IoT-App-Development-Company/AdequateSolarCold/cold-room-design/ColdRoom/3D Renders/AdequateSolarCold_Render_02.png

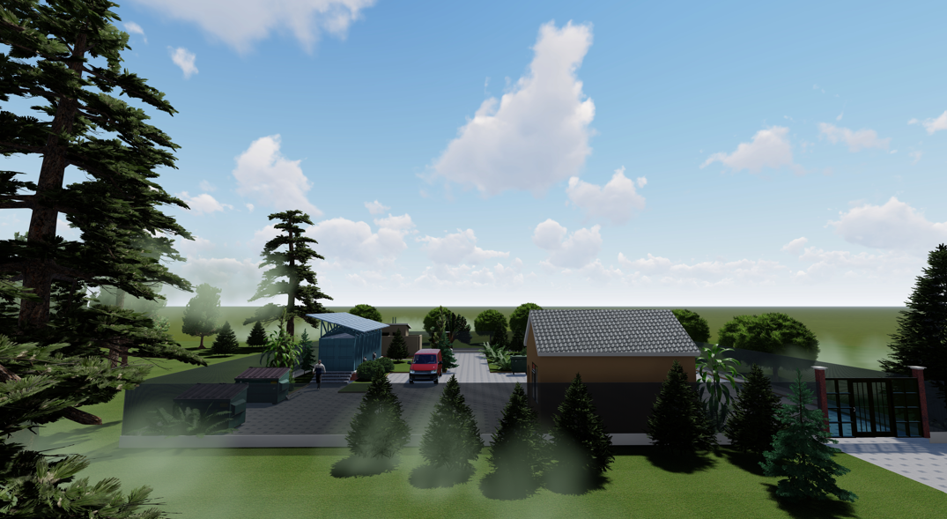
cold-room-design/ColdRoom/3D Renders/AdequateSolarCold_Render_02.png
