IoT-App-Development-Company/AdequateSolarCold/cold-room-design/ColdRoom/CAD Exports/AdequateSolarCold_Exterior.PNG

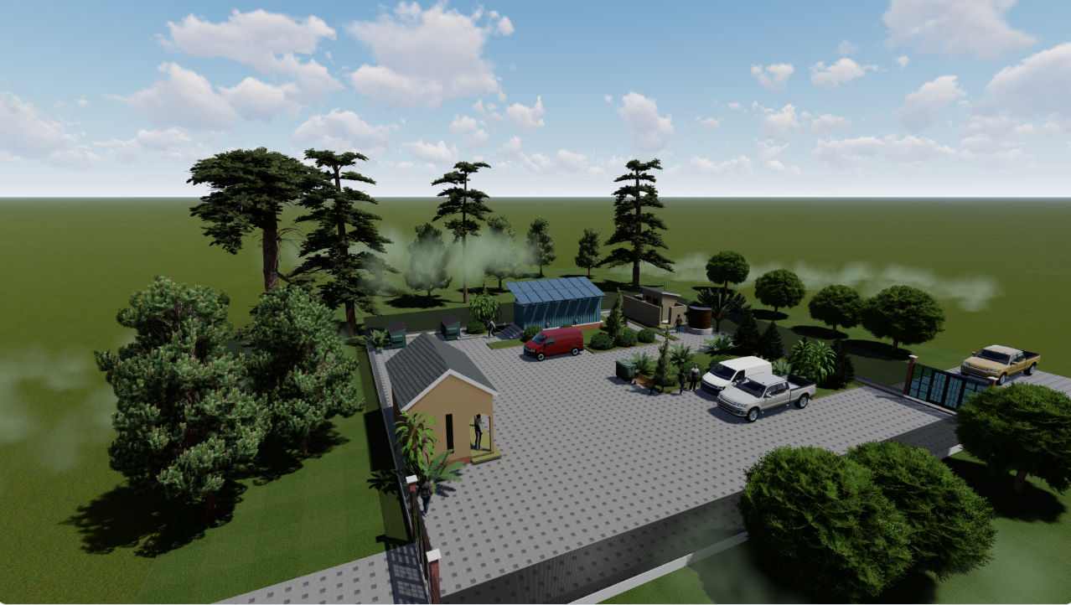
cold-room-design/ColdRoom/CAD Exports/AdequateSolarCold_Exterior.PNG
