IoT-App-Development-Company/AdequateSolarCold/docs/README.md

# Adequate SolarCold documentation

This VitePress site documents the Adequate Infosoft solar cold-chain platform.

## Local development

```text
npm install
npm run docs:dev
```

Use `npm run docs:build` before publishing. The site does not include production analytics or repository-host-specific navigation by default.
