IoT-App-Development-Company/AdequateSolarCold/cold-room-design/SystemArchitecture/README.md

markdown
# Integrated Cooling Solution
- Shows IoT sensor placement strategy
- Airflow optimization diagrams
- Energy consumption estimates
- Maintenance access points
