IoT-App-Development-Company/AdequateSolarCold/cold-room-design/ColdRoom/CAD Exports/Readme

This folder contains CAD exports to pdf of the various components of the cooling hub.
