IoT-App-Development-Company/AdequateSolarCold/cold-room-design/ColdRoom/3D Renders/AdequateSolarCold_Render_01.png

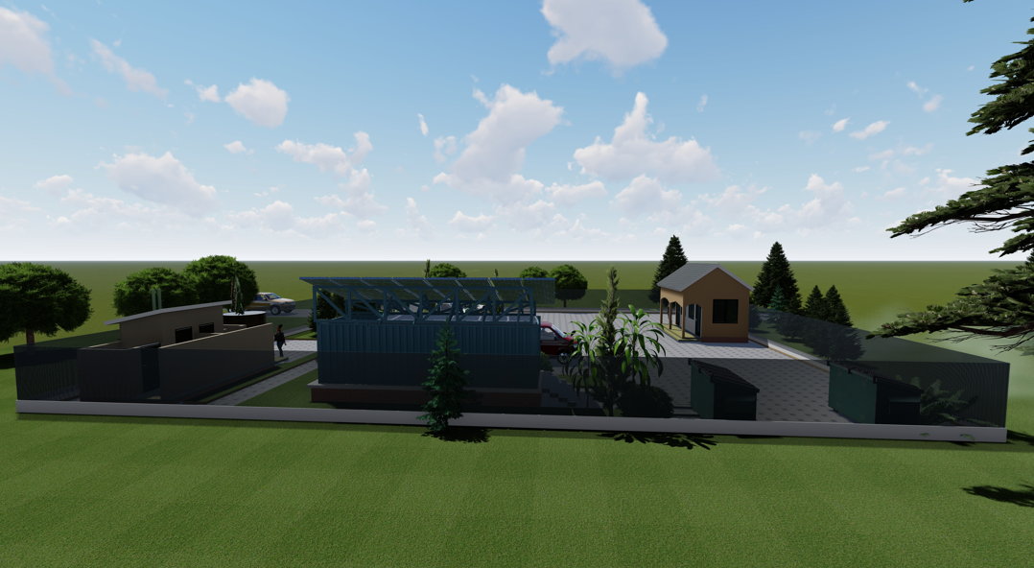
cold-room-design/ColdRoom/3D Renders/AdequateSolarCold_Render_01.png
