IoT-App-Development-Company/AdequateSolarCold/project-media/PCB 2D.PNG

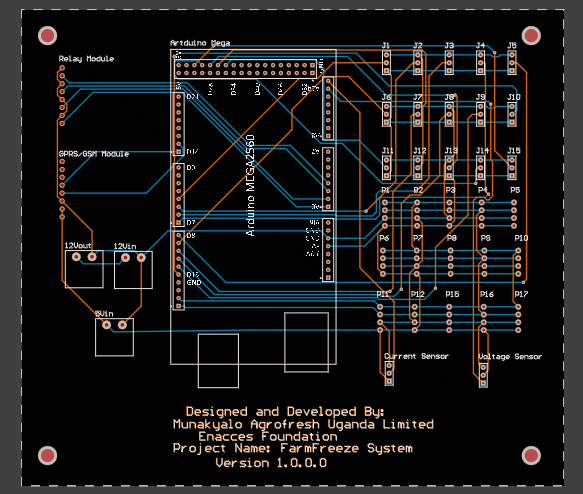
project-media/PCB 2D.PNG
