IoT-App-Development-Company/AdequateSolarCold/project-media/PCB 3D ANGLE.PNG

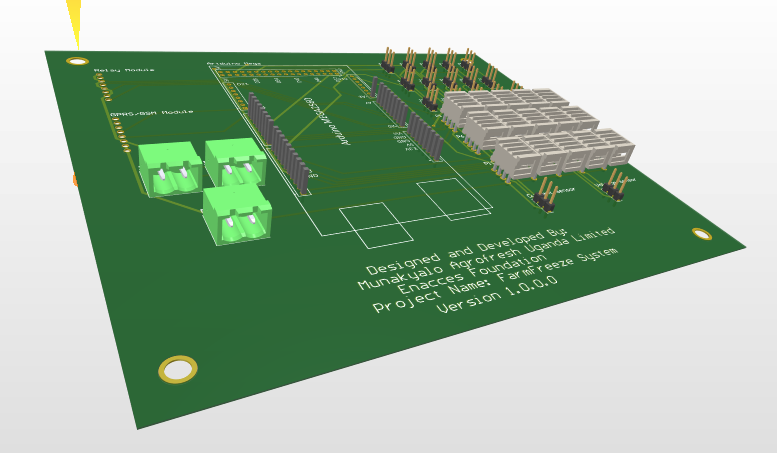
project-media/PCB 3D ANGLE.PNG
