IoT-App-Development-Company/AdequateSolarCold/project-media/PCB 3D BACK.PNG

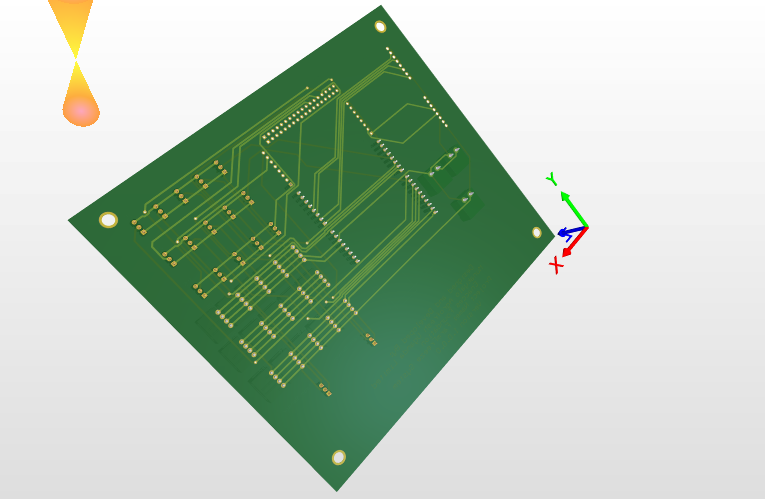
project-media/PCB 3D BACK.PNG
