IoT-App-Development-Company/AdequateSolarCold/project-media/PCB 3D.PNG

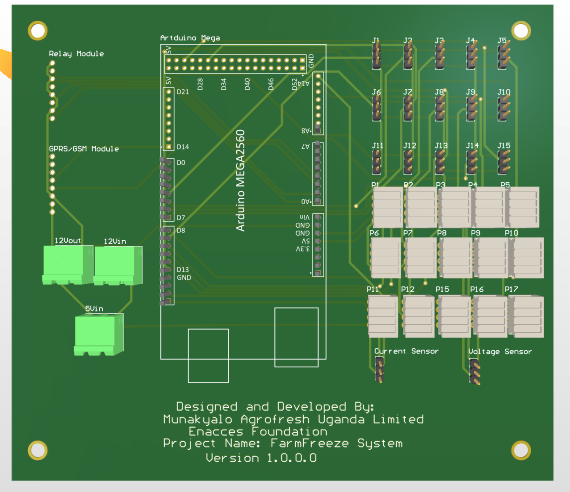
project-media/PCB 3D.PNG
