IoT-App-Development-Company/AdequateSolarCold/project-media/Schematic.PNG

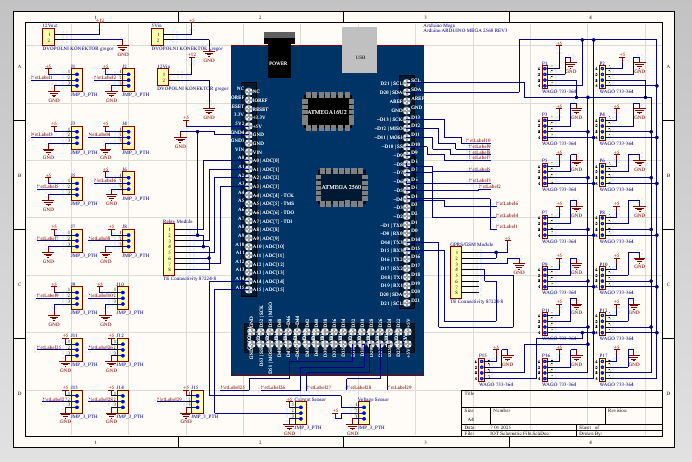
project-media/Schematic.PNG
