IoT-App-Development-Company/AdequateSolarCold/project-media/solarimagedashboard.PNG

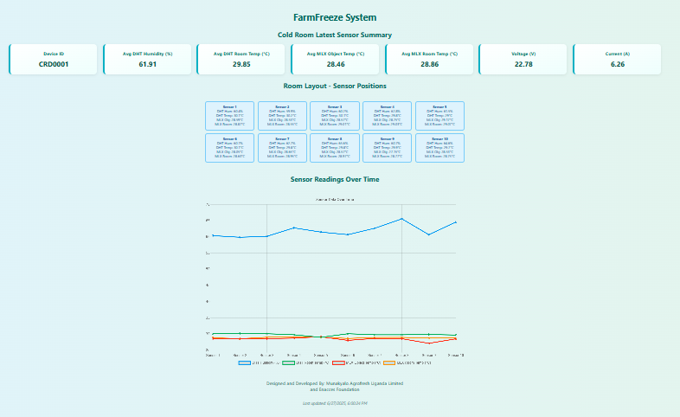
project-media/solarimagedashboard.PNG
