IoT-App-Development-Company/AdequateSolarCold/component-datasheets/readme.md

This folder contains the technical specifications of all key components used across the system. Includes datasheets for sensors (DHT22, MLX90614), power modules, GSM, and Arduino boards.
