IoT-App-Development-Company/AdequateSolarCold/pcb-design/Bill of Material.xlsx

No | Product Name | Product Description | Quantity | Unit of Measure | Unit Cost | Supplier | Link
1 | Arduino Mega | ARDUINO MEGA 2560 | 1 | Pcs | 80000 | Bbiri Centre | https://www.bbiri-centre.com/product-page/arduino-mega-2560
2 | DHT22 | DHT-22 DHT22 Humidity And Temperature Sensor | 10 | Pcs | 25000 | Bbiri Centre | https://www.bbiri-centre.com/product-page/dht22-humidity-and-temperature-sensor
3 | Temperature Sensor | GY-906 MLX90614 non-contact Infrared Temperature Sensor Module I2C | 10 | Pcs | 50000 | Bbiri Centre | https://www.bbiri-centre.com/product-page/gy-906-mlx90614-non-contact-infrared-temperature-sensor-module-i2c
4 | Voltage Sensor | ZMPT101B Voltage Sensor | 1 | Pcs | 15000 | Bbiri Centre | https://www.bbiri-centre.com/product-page/voltage-sensor
5 | Current Sensor | ACS712T 30A Range Current Sensor Module | 1 | Pcs | 20000 | Bbiri Centre | https://www.bbiri-centre.com/product-page/acs712t-30a-range-current-sensor-module
6 | Relay Module | 30A 4 Channel Relay Module Expansion Board (12VDC) | 1 | Pcs | 142000 | Neriko Electronics | https://nerikoelectronics.com/product/30a-4-channel-relay-module-expansion-board-12vdc-TUkif1
7 | Battery Shield | Double 18650 Lithium Battery Shield V8 5V 3A 3V 1A Power Bank Battery Charging M | 1 | Pcs | 30000 | Bbiri Centre | https://www.bbiri-centre.com/product-page/double-18650-lithium-battery-shield-v8-5v-3a-3v-1a-power-bank-battery-charging-m
8 | Lithium Batteries | Original 3.7V 7800mAh 18650 Polymer Lithium Ion Battery (LiPo) | 2 | Pcs | 18000 | Neriko Electronics | https://nerikoelectronics.com/product/18650-polymer-lithium-ion-battery-lipo-37v-2600mah-jBeYN4
9 | Connecting Wires | 1m of 22AWG 0.34mm Ribbon Wire 4Pin Cable | 10 | Meters | 4000 | Bbiri Centre | https://www.bbiri-centre.com/product-page/1m-of-22awg-0-34mm-ribbon-wire-4pin-cable
10 | Soldering Wire | 1 Roll of Lead-free Solder Wire Sn99.3 Solder Wire 0.8 50g Smooth Tin | 1 | Pcs | 20000 | Bbiri Centre | https://www.bbiri-centre.com/product-page/1-roll-of-lead-free-solder-wire-sn99-3-solder-wire-0-8-50g-smooth-tin
11 | GSM Module | SIM800C GSM GPRS Module 5V/3.3V TTL Development Board SIM800C | 1 | Pcs | 60000 | Bbiri Centre | https://www.bbiri-centre.com/product-page/sim800c-gsm-gprs-module-5v-3-3v-ttl-development-board-sim800c
12 | Simcard | MTN Simcard | 1 | Pcs | 5000 | MTN Uganda | https://www.mtn.co.ug/helppersonal/sim-registration/
