IoT-App-Development-Company/AdequateSolarCold/cold-room-design/ColdRoom/Cooling Hub BOQs.xlsx

BUDGET FOR THE SETTING UP OF A COOLING HUB
Sn | Description | Unit | Qty | Rate (Ugx) | Amount (Ugx) | Amount (Usd)
 | All rates and prices will be dependent on the local market prices.
A | Approval & Permits
1 | Acquisition of local building permit | Ls | 1 | 2000000 | 2000000 | 526.3157895
 |  |  |  |  | 0 | 0
B | Structure |  |  |  | 0 | 0
1 | Container foundation | Ls | 1 | 1000000 | 1000000 | 263.1578947
2 | 20ft Container | Ls | 1 | 12000000 | 12000000 | 3157.894737
3 | Transport, loading and offloading | Ls | 1 | 2300000 | 2300000 | 605.2631579
 |  |  |  |  | 0 | 0
C | Internal Members |  |  |  | 0 | 0
1 | Storage crates (HDPE) | No. | 125 | 55000 | 6875000 | 1809.210526
 |  |  |  |  | 0 | 0
D | External Works |  |  |  | 0 | 0
1 | Latrine (02 Stance) | Ls | 1 | 3000000 | 3000000 | 789.4736842
2 | Office & Guard House | Ls | 1 | 10000000 | 10000000 | 2631.578947
3 | Compound Works | Ls | 1 | 3500000 | 3500000 | 921.0526316
4 | Gates & Fence | Ls | 1 | 5000000 | 5000000 | 1315.789474
5 | Rain water System | Ls | 1 | 5000000 | 5000000 | 1315.789474
E | Solar System
1 | Solar Panels | No. | 16 | 300000 | 4800000 | 1263.157895
2 | Solar Rack | Ls | 1 | 1500000 | 1500000 | 394.7368421
3 | Batteries | No. | 8 | 450000 | 3600000 | 947.3684211
4 | Inverter | No. | 1 | 5000000 | 5000000 | 1315.789474
5 | Earthing, lightening arrestor and other accessories | No. | 1 | 2000000 | 2000000 | 526.3157895
 |  |  |  |  | 0 | 0
F | Cooling System |  |  |  | 0 | 0
1 | Axial fans | Ls | 4 | 800000 | 3200000 | 842.1052632
2 | Electric control panel and componets (IOT system) | Ls | 1 | 3000000 | 3000000 | 789.4736842
3 | Compressor | Ls | 1 | 500000 | 500000 | 131.5789474
4 | Cooling fans | Ls | 4 | 650000 | 2600000 | 684.2105263
5 | Insulation Membrane | Ls | 1 | 2000000 | 2000000 | 526.3157895
 | Sub Total 1 |  |  |  | 78875000 | 20756.57895
 | Add; 5% Contigency |  |  |  | 4732500 | 1245.394737
 | Sub Total 2 |  |  |  | 83607500 | 22001.97368
 | Add; 18% VAT |  |  |  | 15049350 | 3960.355263
 | Grand Total |  |  |  | 98656850 | 25962.32895
