IoT-App-Development-Company/AdequateSolarCold/cold-room-design/ColdRoom/FreeCAD Files/Solar and Cold Room (FreeCAD 1.0.1).FCStd

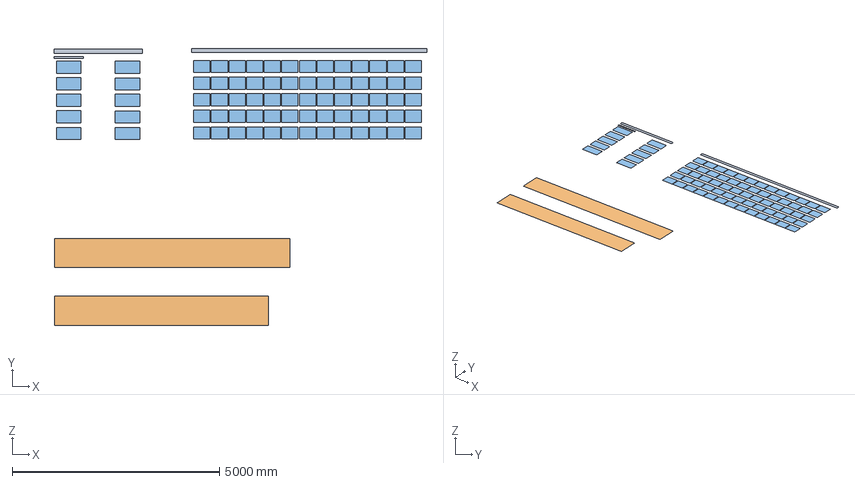
[picture p12: CAD file, 2026-10-26]
cold-room-design/ColdRoom/FreeCAD Files/Solar and Cold Room (FreeCAD 1.0.1).FCStd
9000.8 x 6681.0 x 0 mm
Structural___Bearing_Pen_No__174
Interior___Furniture
Structural___Bearing_Pen_No__44
