IoT-App-Development-Company/AdequateSolarCold/enclosure-design/3D Models/IOT B oard FIle.step

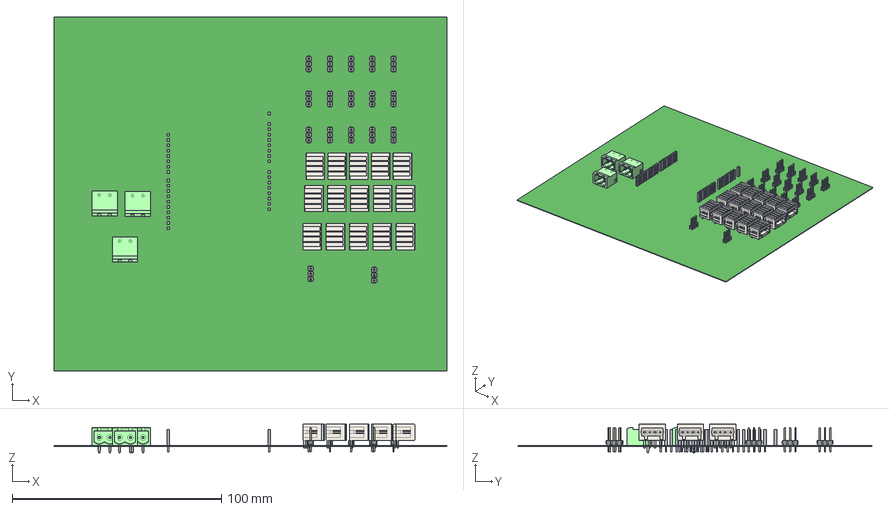
[picture p13: CAD file, 2026-10-26]
enclosure-design/3D Models/IOT B oard FIle.step
187.7 x 169.2 x 13.8 mm
M20-999-MOULD x 17
M20-999-PIN x 51
mstba_2.5-2-g-5.08 x 3
Extruded x 69
