IoT-App-Development-Company/AdequateSolarCold/enclosure-design/STL Files/IOT Casing 4.stl

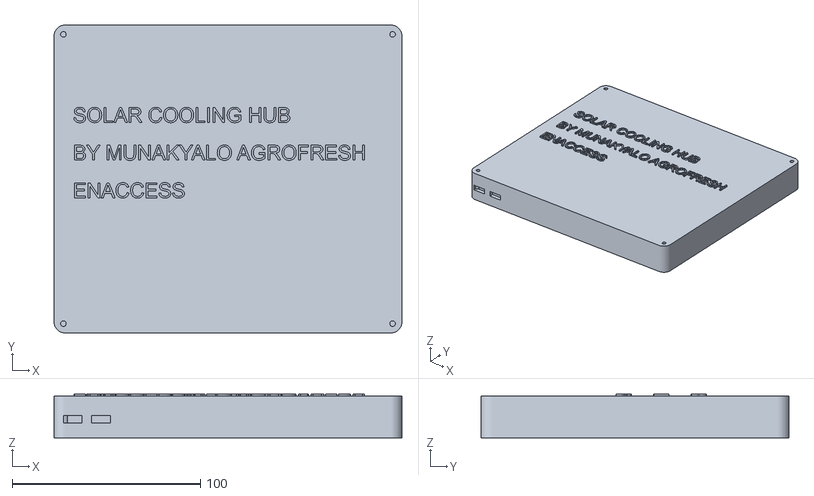
[picture p14: CAD file, 2026-10-26]
enclosure-design/STL Files/IOT Casing 4.stl
184.9 x 163.6 x 23.3
