IoT-App-Development-Company/AdequateSolarCold/cold-room-design/ColdRoom/FreeCAD Files/Guard House and Office (FreeCAD 1.0.1).FCStd

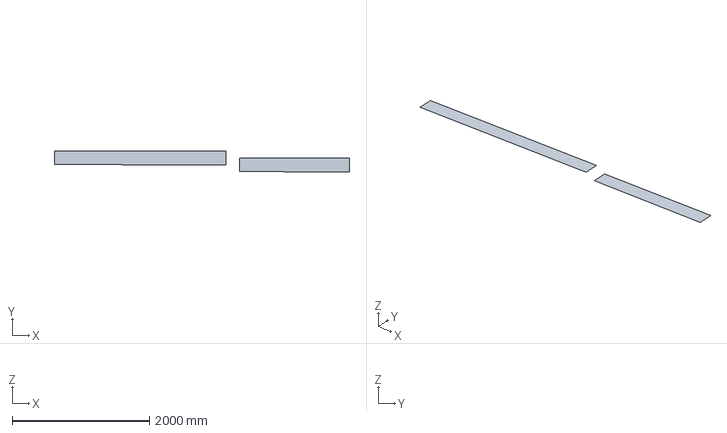
[picture p15: CAD file, 2026-10-26]
cold-room-design/ColdRoom/FreeCAD Files/Guard House and Office (FreeCAD 1.0.1).FCStd
4300.2 x 308.0 x 0 mm
