IoT-App-Development-Company/AdequateSolarCold/cold-room-design/ColdRoom/FreeCAD Files/Rain Water tank (FreeCAD 1.0.1).FCStd

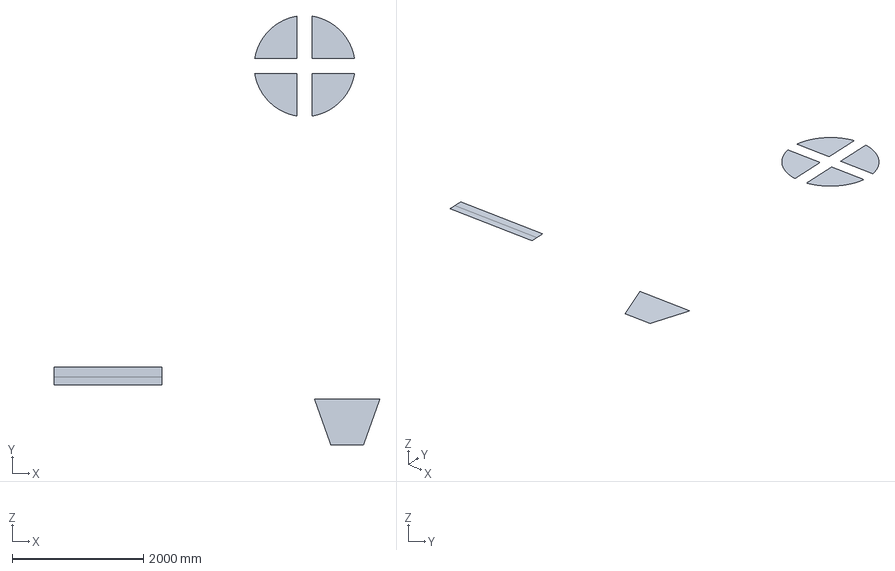
[picture p16: CAD file, 2026-10-26]
cold-room-design/ColdRoom/FreeCAD Files/Rain Water tank (FreeCAD 1.0.1).FCStd
4967.3 x 6532.8 x 0 mm
