IoT-App-Development-Company/AdequateSolarCold/cold-room-design/ColdRoom/FreeCAD Files/20 Ft Container and Cooling System Units (FreeCAD 1.0.1).FCStd

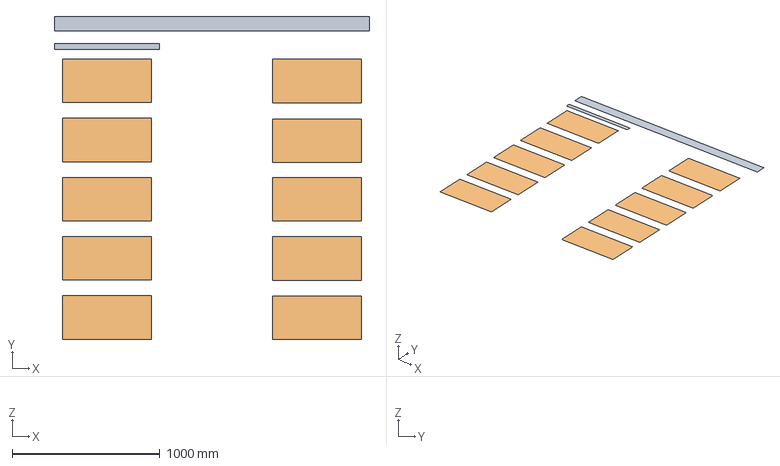
[picture p17: CAD file, 2026-10-26]
cold-room-design/ColdRoom/FreeCAD Files/20 Ft Container and Cooling System Units (FreeCAD 1.0.1).FCStd
2130.0 x 2184.8 x 0 mm
Structural___Bearing_Pen_No__174
Structural___Bearing_Pen_No__44
