IoT-App-Development-Company/AdequateSolarCold/cold-room-design/ColdRoom/FreeCAD Files/02 Stance Latrine (FreeCAD 1.0.1).FCStd

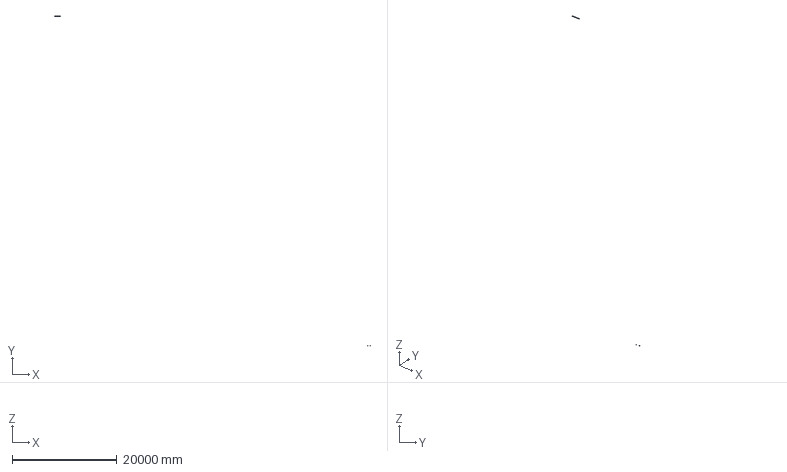
[picture p18: CAD file, 2026-10-26]
cold-room-design/ColdRoom/FreeCAD Files/02 Stance Latrine (FreeCAD 1.0.1).FCStd
60396.5 x 63020.1 x 0 mm
Shell___Roof_Pen_No__1
Structural___Bearing
