IoT-App-Development-Company/AdequateSolarCold/(list of files, cad)

Other CAD files:
cold-room-design/ColdRoom/FreeCAD Files/Gate and Chainlink (FreeCAD 1.0.1).FCStd
enclosure-design/STL Files/IOT B oard FIle.stl
