IoT-App-Development-Company/AdequateSolarCold/enclosure-design/Assembly/All Sensors Extended.jpg

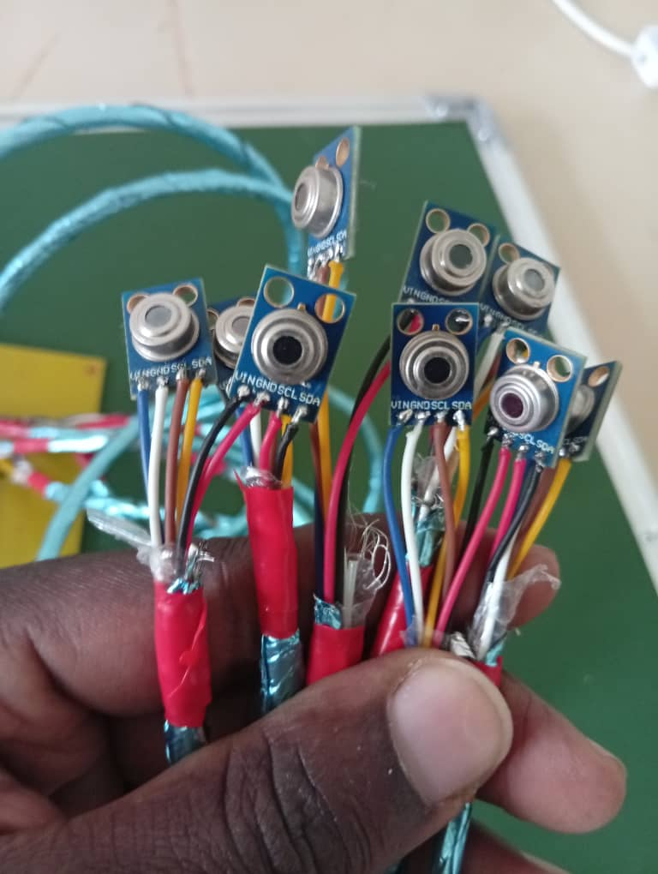
enclosure-design/Assembly/All Sensors Extended.jpg
