IoT-App-Development-Company/AdequateSolarCold/enclosure-design/Assembly/Blank CIrcuit Board.jpg

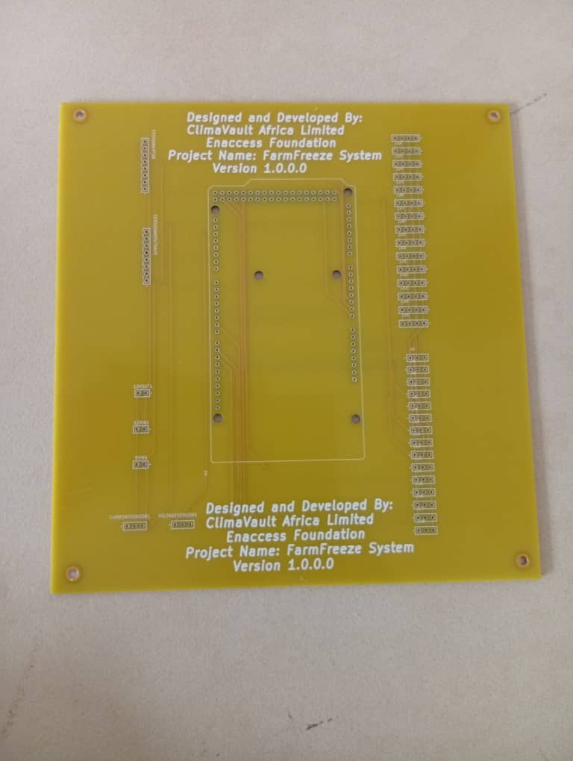
enclosure-design/Assembly/Blank CIrcuit Board.jpg
