IoT-App-Development-Company/AdequateSolarCold/enclosure-design/Assembly/Demo Assembly.jpg

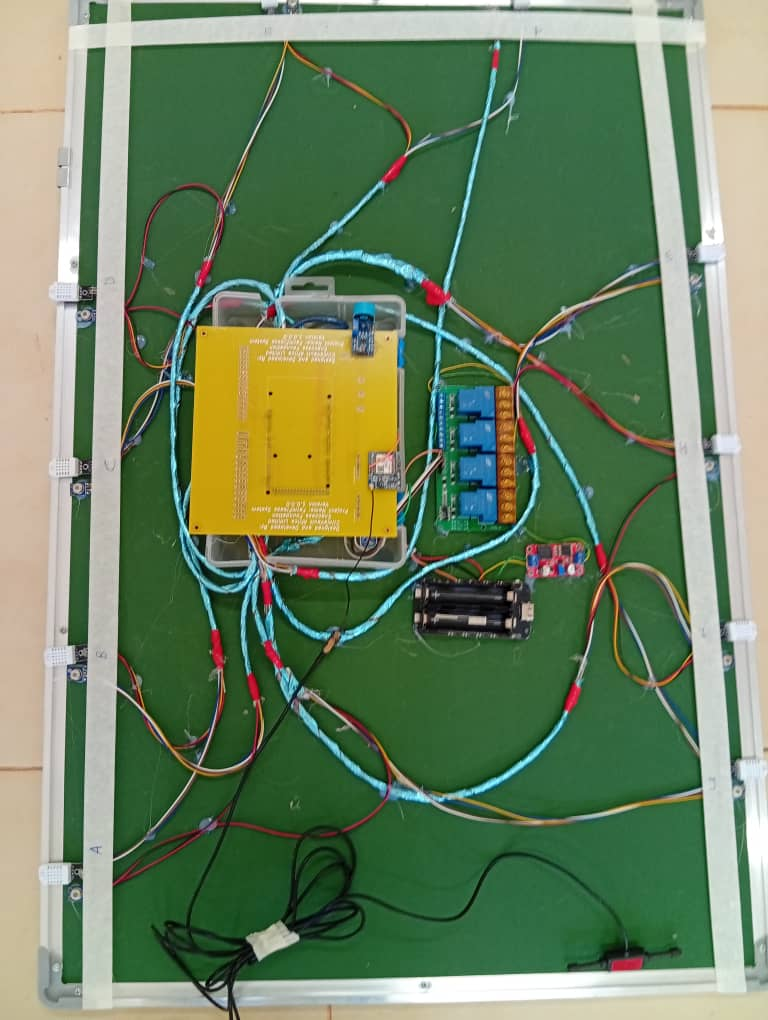
enclosure-design/Assembly/Demo Assembly.jpg
