IoT-App-Development-Company/AdequateSolarCold/enclosure-design/Assembly/Relay Connection.jpg

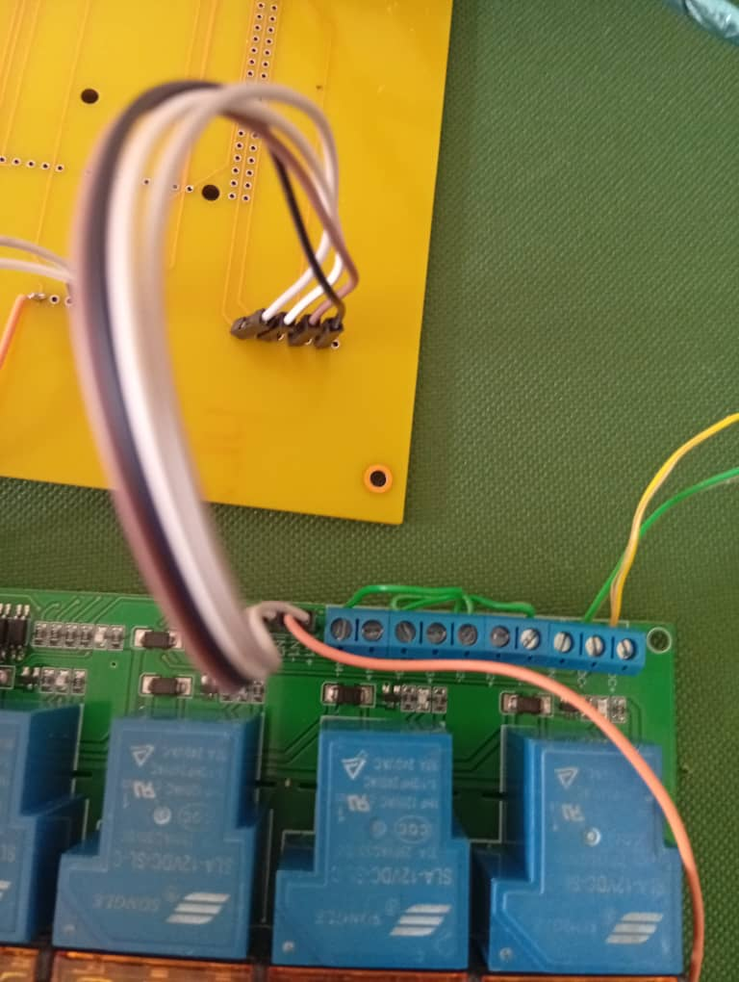
enclosure-design/Assembly/Relay Connection.jpg
