IoT-App-Development-Company/AdequateSolarCold/enclosure-design/Assembly/Sensor A.jpg

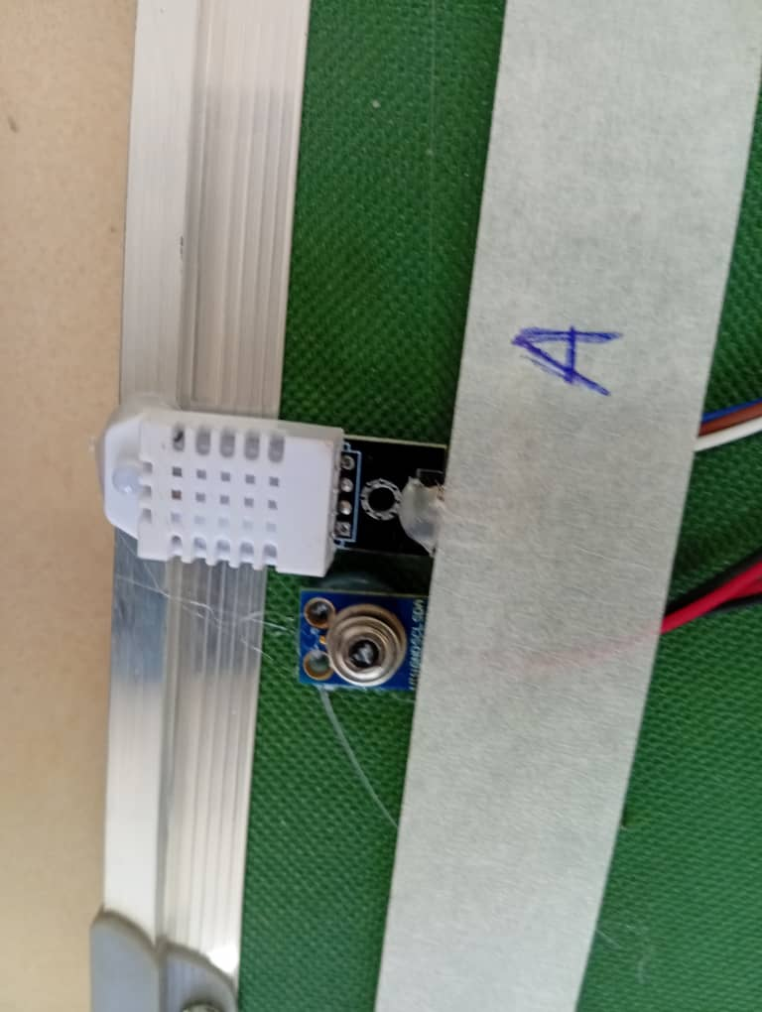
enclosure-design/Assembly/Sensor A.jpg
