IoT-App-Development-Company/AdequateSolarCold/enclosure-design/Assembly/Soldering.jpg

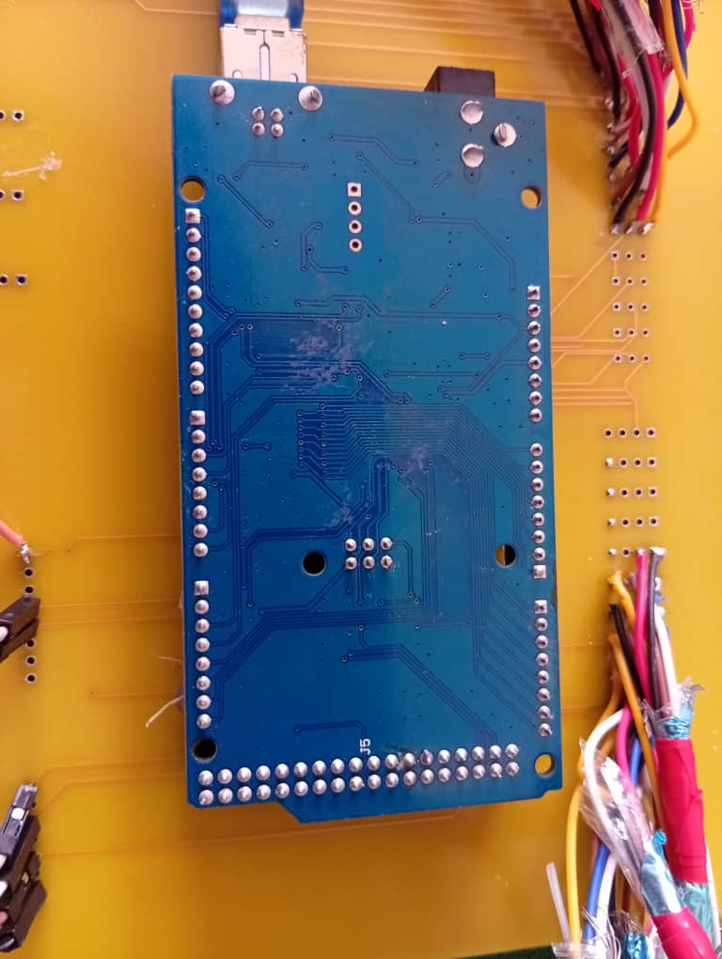
enclosure-design/Assembly/Soldering.jpg
