IoT-App-Development-Company/AdequateSolarCold/system-testing/README.md

markdown
# Validation Protocols
- Test equipment: Fluke 179 multimeter, Testo 605i hygrometer
- Stress testing: 48hr continuous operation
- Safety: Leakage current tests, emergency shutdown
