IoT-App-Development-Company/AdequateSolarCold/cold-room-design/ColdRoom/CAD Exports/02 Stance VIP Latrine.pdf

04

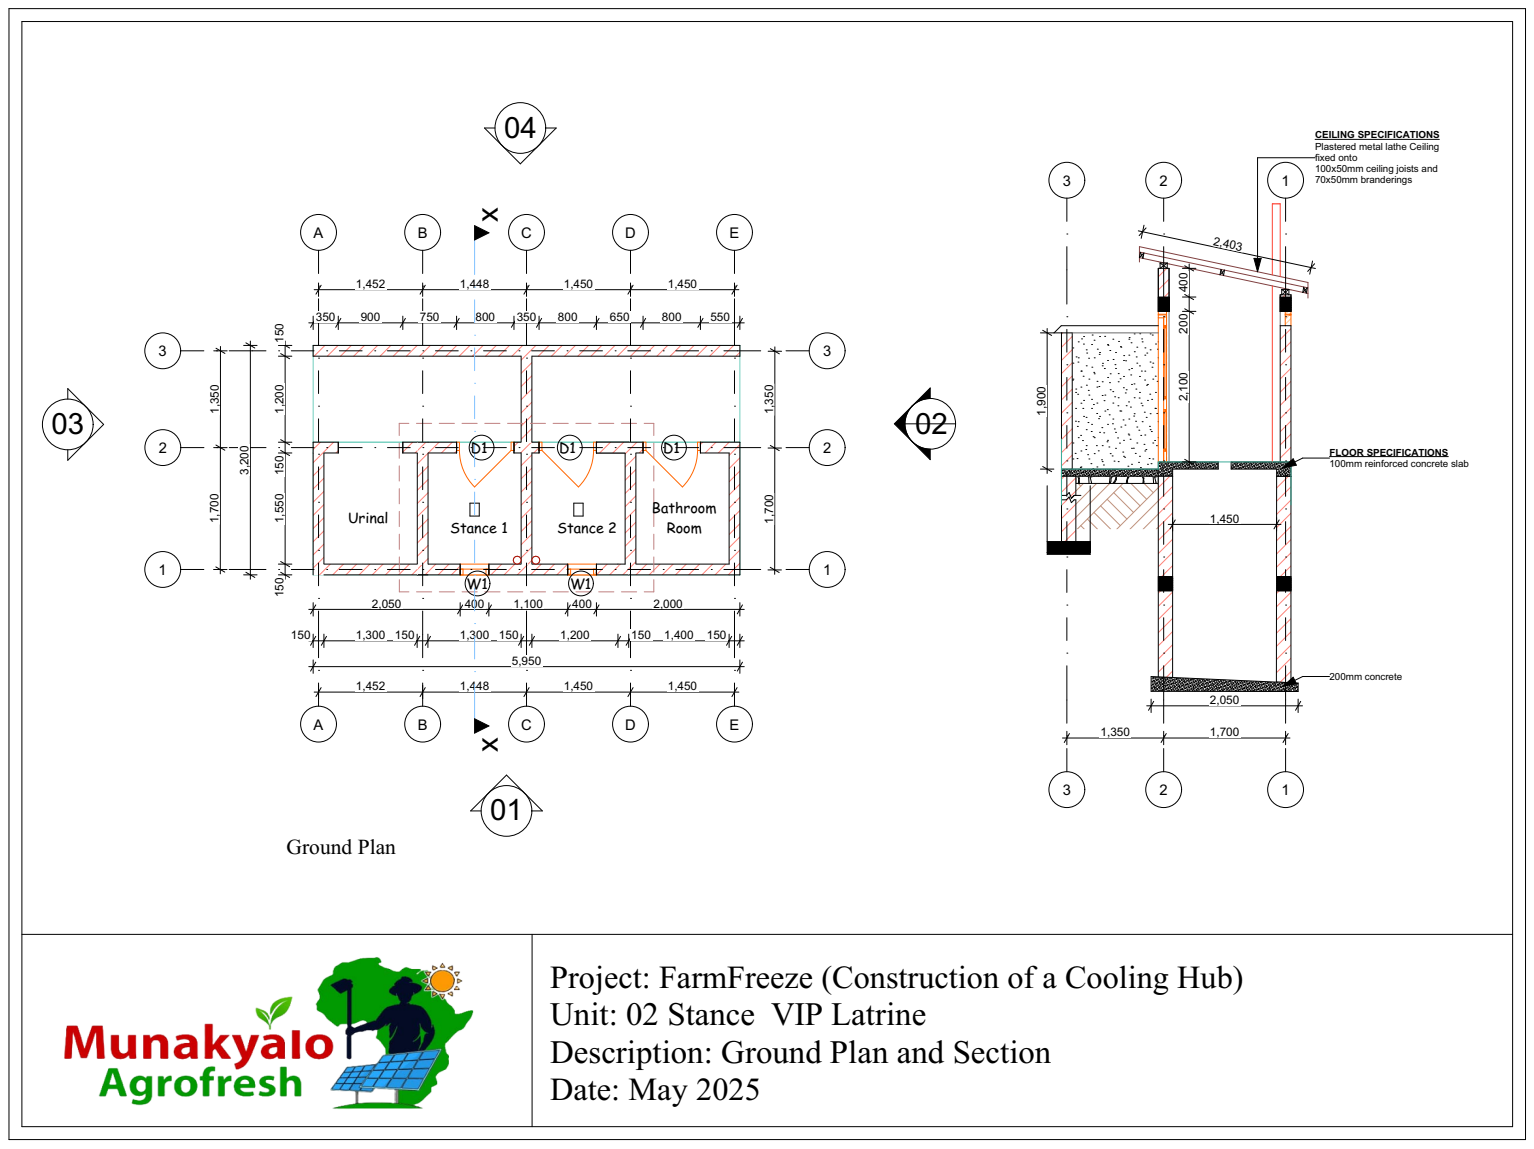
[picture p25: page 1]
GSPublisherVersion 0.0.100.100; 70x50mm branderings; 200mm concrete; Stance 1; Stance 2; Bathroom Room Urinal; Ground Plan

CEILING SPECIFICATIONS
Plastered metal lathe Ceiling
fixed onto
100x50mm ceiling joists and

FLOOR SPECIFICATIONS
100mm reinforced concrete slab

Project: FarmFreeze (Construction of a Cooling Hub)
Unit: 02 Stance VIP Latrine
Description: Ground Plan and Section
Date: May 2025

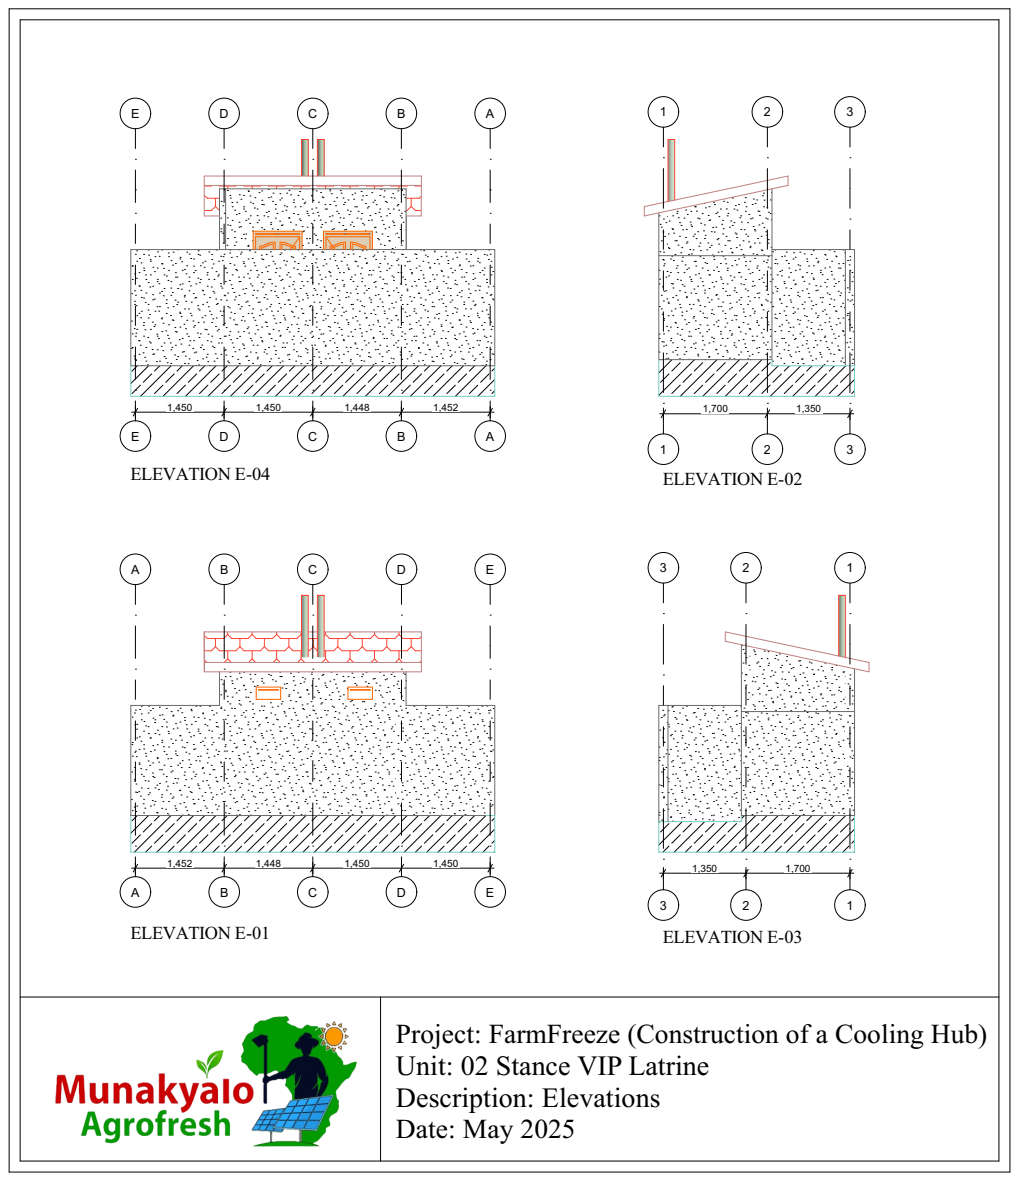
[picture p26: page 2]
ELEVATION E-04; ELEVATION E-02; ELEVATION E-01; ELEVATION E-03

Project: FarmFreeze (Construction of a Cooling Hub)
Unit: 02 Stance VIP Latrine
Description: Elevations
Date: May 2025

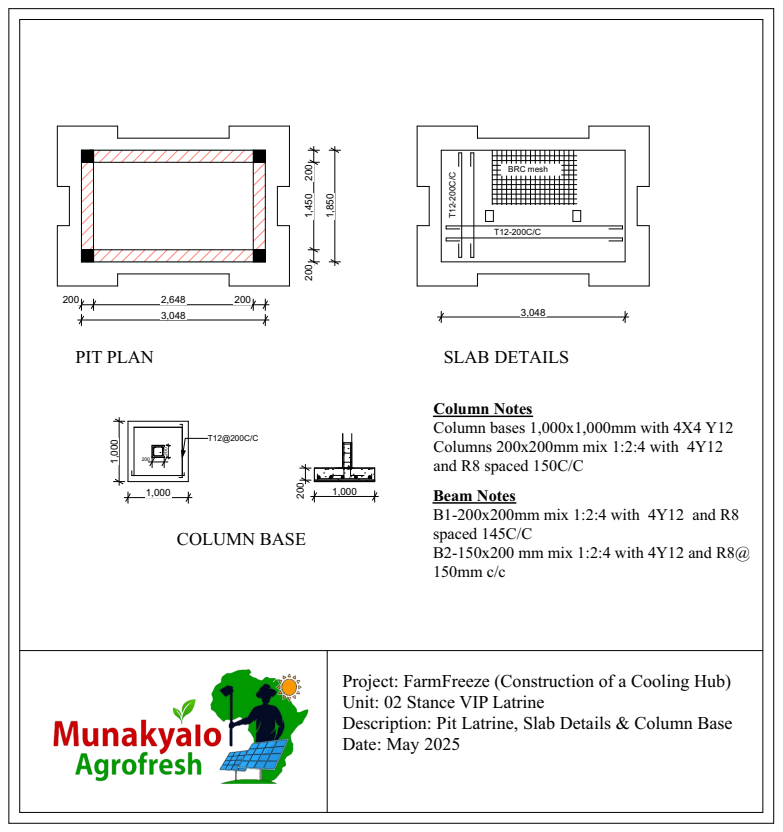
[picture p27: page 3]
BRC mesh; PIT PLAN; SLAB DETAILS; COLUMN BASE

Column Notes
Column bases 1,000x1,000mm with 4X4 Y12
Columns 200x200mm mix 1:2:4 with 4Y12
and R8 spaced 150C/C
Beam Notes
B1-200x200mm mix 1:2:4 with 4Y12 and R8
spaced 145C/C
B2-150x200 mm mix 1:2:4 with 4Y12 and R8@

Project: FarmFreeze (Construction of a Cooling Hub)
Unit: 02 Stance VIP Latrine
Description: Pit Latrine, Slab Details & Column Base
Date: May 2025
