IoT-App-Development-Company/AdequateSolarCold/cold-room-design/ColdRoom/CAD Exports/Cold Room Designs 27.8.25.pdf

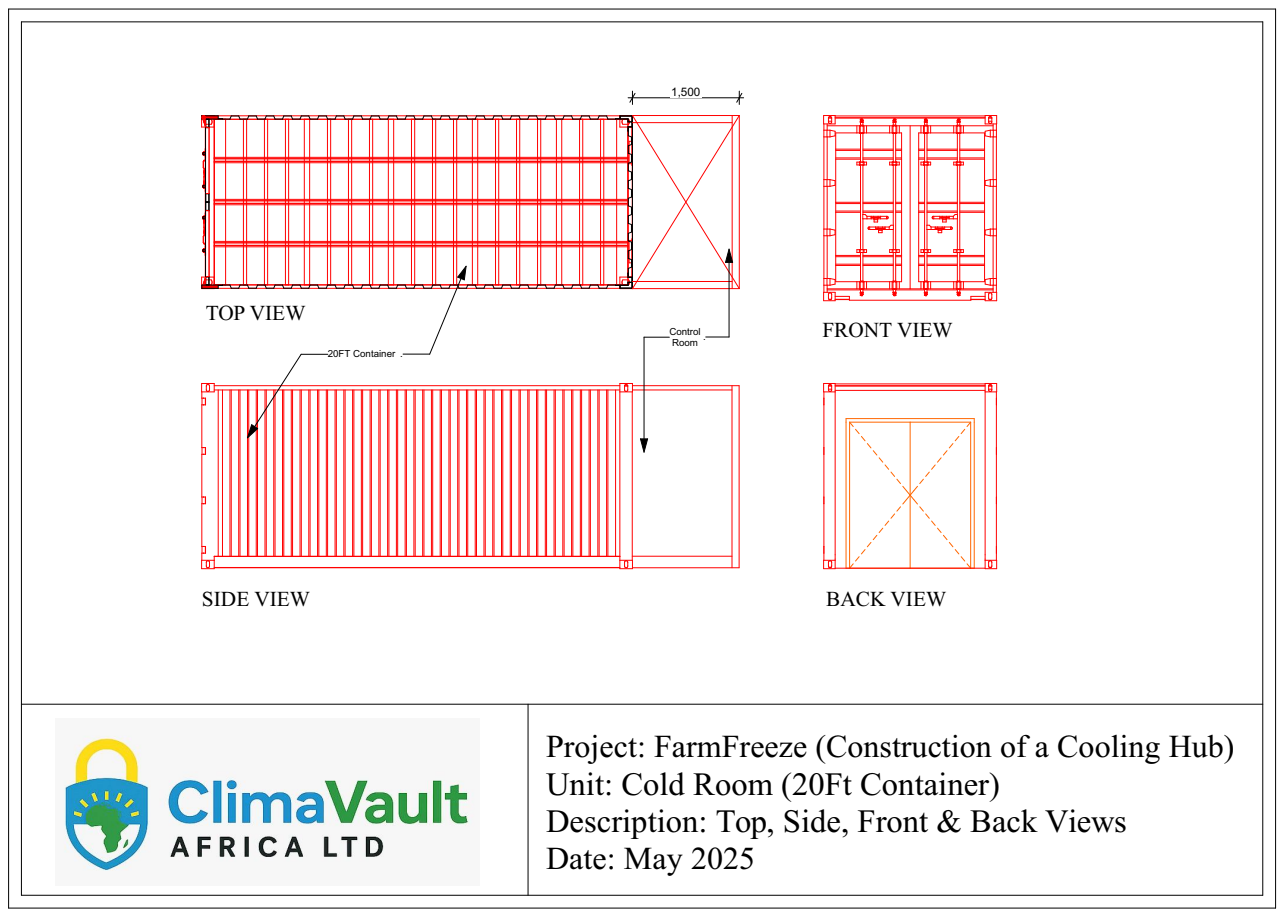
[picture p28: page 1]
GSPublisherVersion 0.1.100.100; 20FT Container .; Control Room .; TOP VIEW; FRONT VIEW; SIDE VIEW; BACK VIEW

Project: FarmFreeze (Construction of a Cooling Hub)
Unit: Cold Room (20Ft Container)
Description: Top, Side, Front & Back Views
Date: May 2025

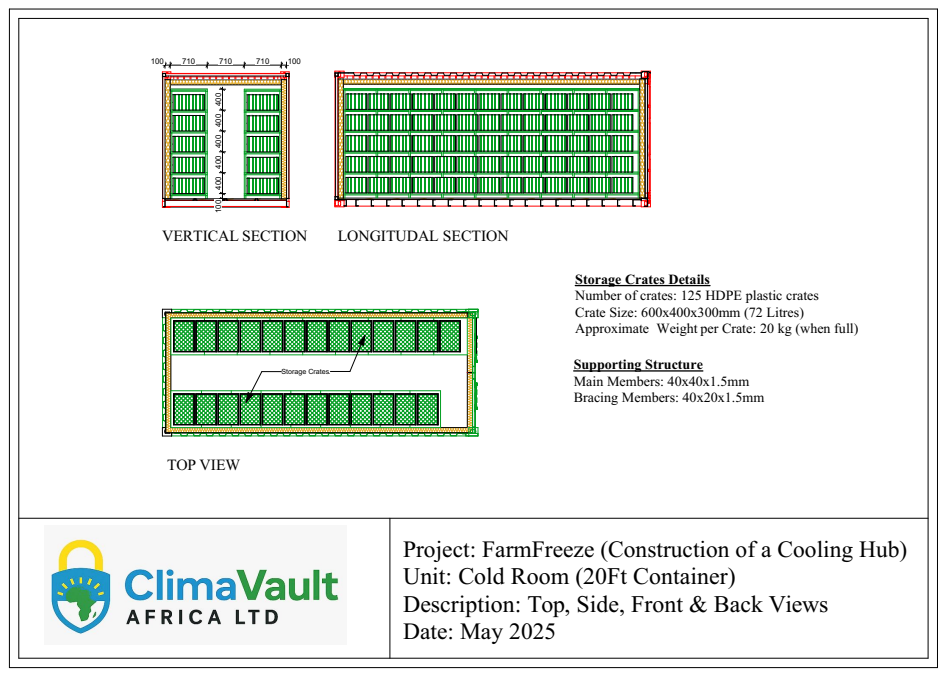
[picture p29: page 2]
GSPublisherVersion 0.1.100.100; TOP VIEW; VERTICAL SECTION; LONGITUDAL SECTION; Supporting Structure Main Members: 40x40x1.5mm Bracing Members: 40x20x1.5mm; Storage Crates.

Storage Crates Details
Number of crates: 125 HDPE plastic crates
Crate Size: 600x400x300mm (72 Litres)
Approximate Weight per Crate: 20 kg (when full)

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

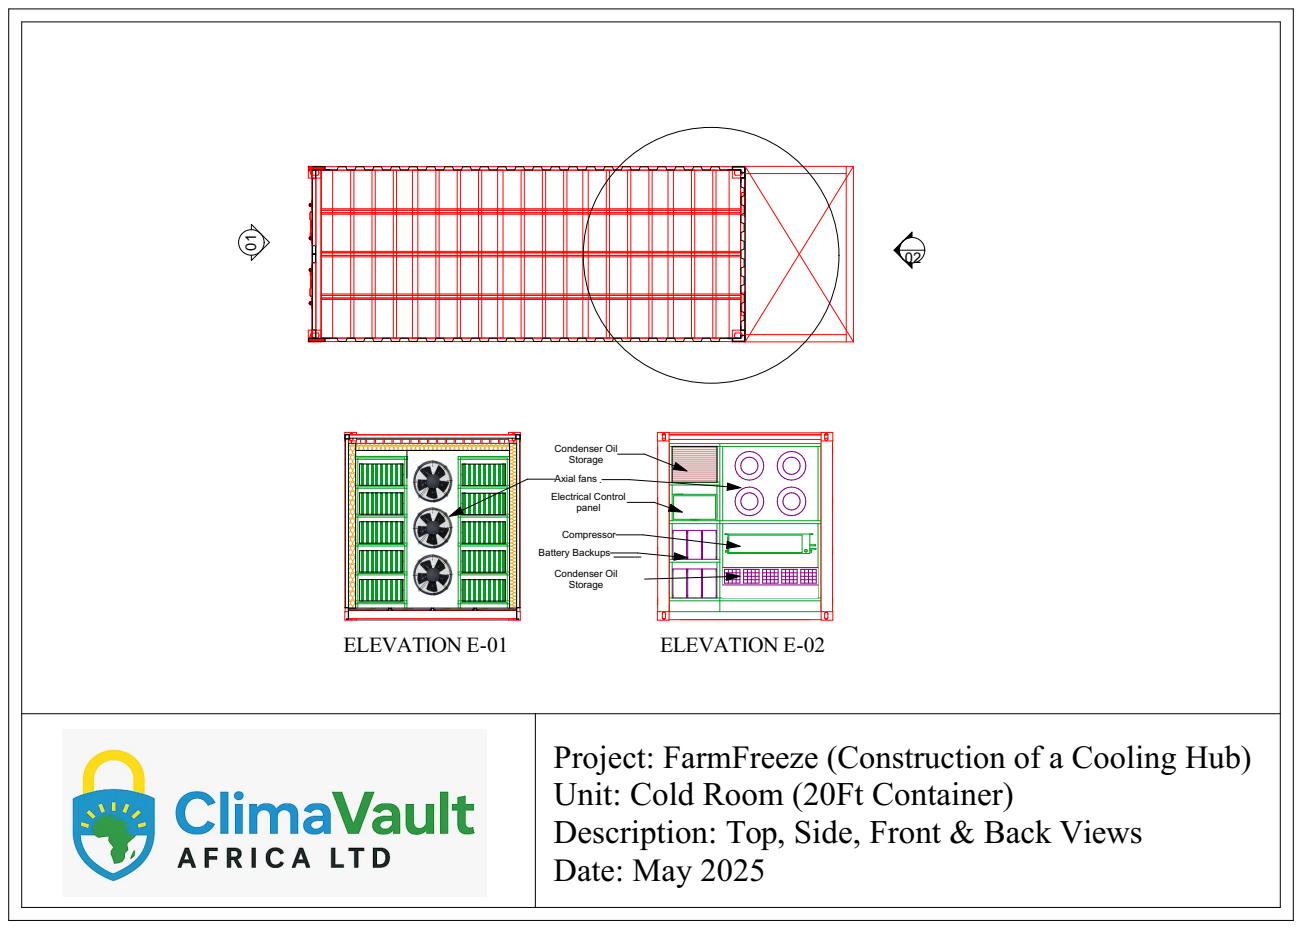
[picture p30: page 3]
GSPublisherVersion 0.0.100.100; ELEVATION E-01; ELEVATION E-02; Axial fans; Battery Backups; Electrical Control panel; Condenser Oil Storage; Compressor

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

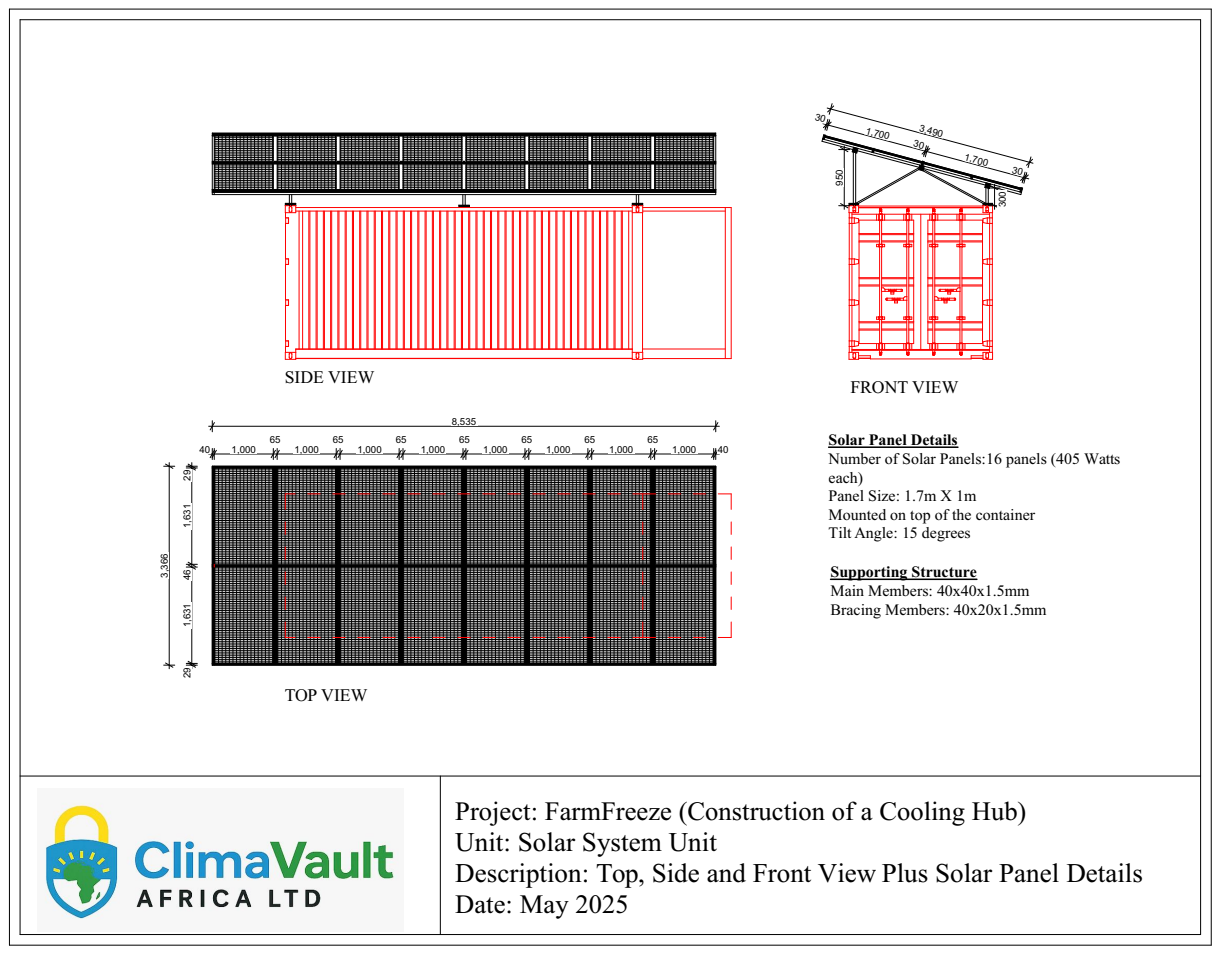
[picture p31: page 4]
GSPublisherVersion 0.1.100.100; SIDE VIEW; TOP VIEW; FRONT VIEW; Supporting Structure Main Members: 40x40x1.5mm Bracing Members: 40x20x1.5mm

Solar Panel Details
Number of Solar Panels:16 panels (405 Watts
each)
Panel Size: 1.7m X 1m
Mounted on top of the container
Tilt Angle: 15 degrees

Project: FarmFreeze (Construction of a Cooling Hub)
Unit: Solar System Unit
Description: Top, Side and Front View Plus Solar Panel Details
Date: May 2025

30,000

30,000

14,000 | 2,000 | 1,400 | 6,600 | 1,475 | 3,500 | 1,025
1,400 | 5,950 | 22,650 12,978 6,050 6,497 3,200 1,275
2,000 | 2,430 | 25,570

LATRINE

# Project: FarmFreeze (Construction of a Cooling Hub) Unit: Site Layout (30x30m plot) Description: Container, Guard & Gate House, Latrine and Compund Date: May 2025

OFFICE & GUARD HOUSE

3

2

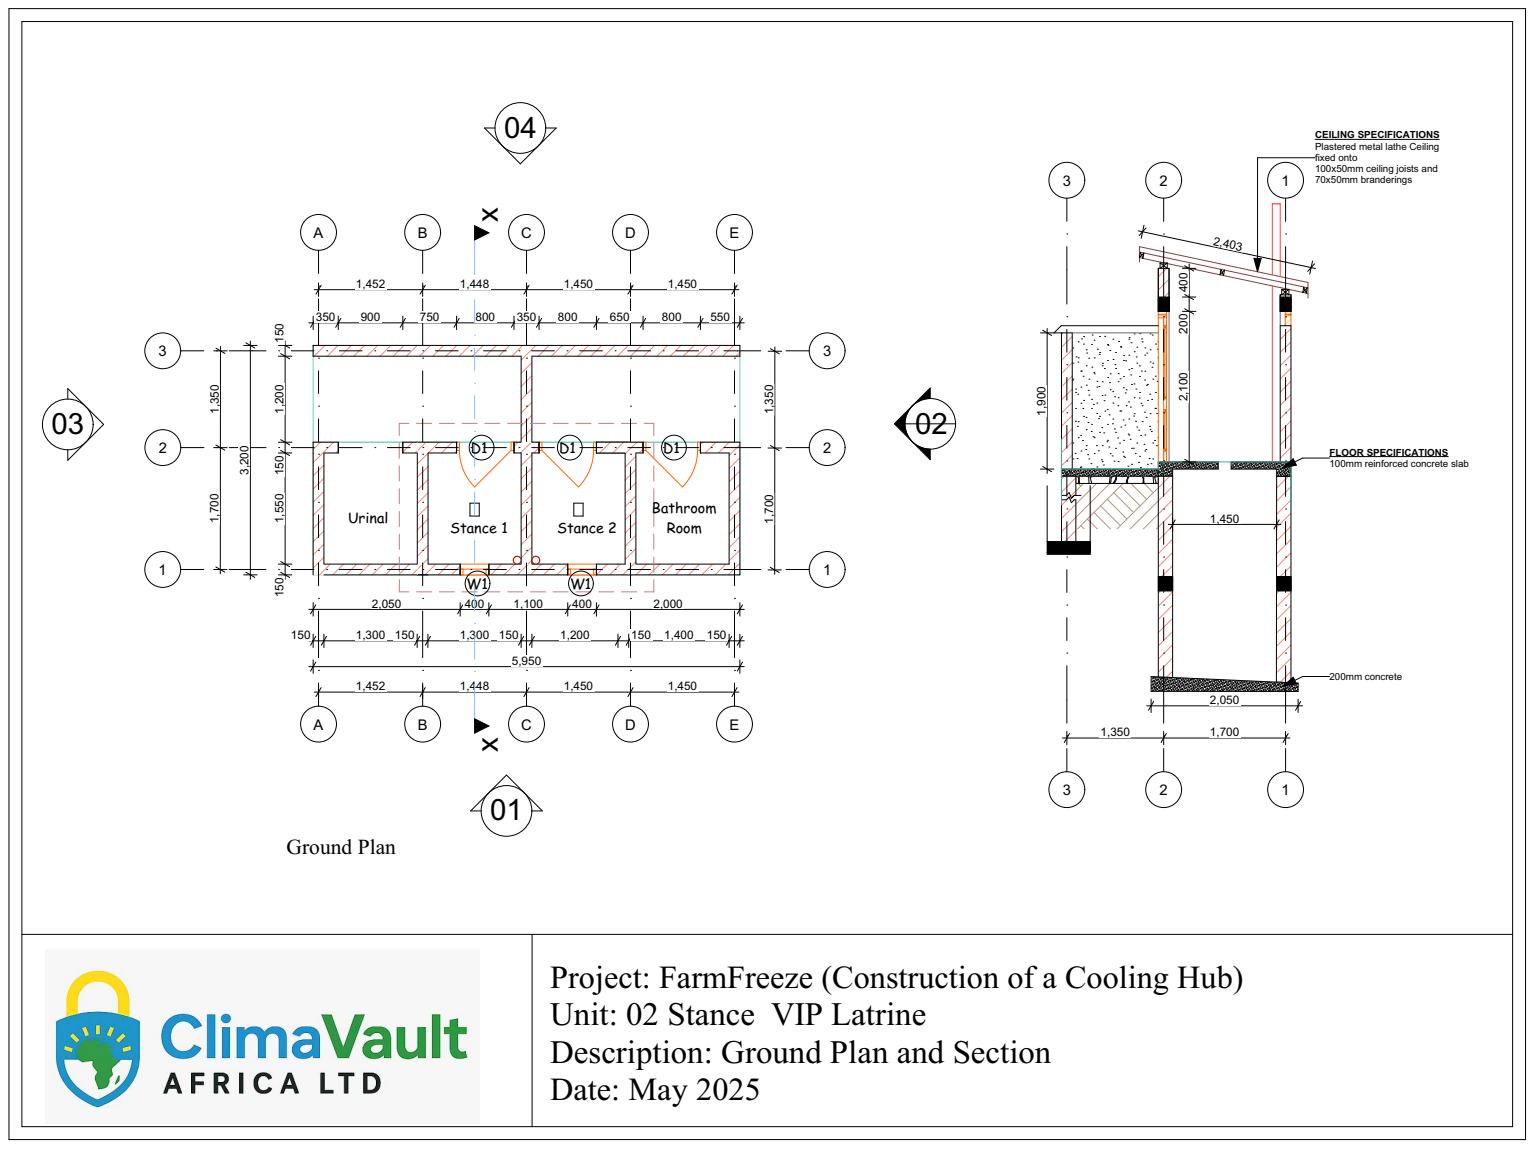
[picture p32: page 6]
70x50mm branderings; 200mm concrete; Stance 1; Stance 2; Bathroom Room Urinal; Ground Plan

CEILING SPECIFICATIONS
Plastered metal lathe Ceiling
fixed onto
100x50mm ceiling joists and

FLOOR SPECIFICATIONS
100mm reinforced concrete slab

Project: FarmFreeze (Construction of a Cooling Hub)
Unit: 02 Stance VIP Latrine
Description: Ground Plan and Section
Date: May 2025

1

2

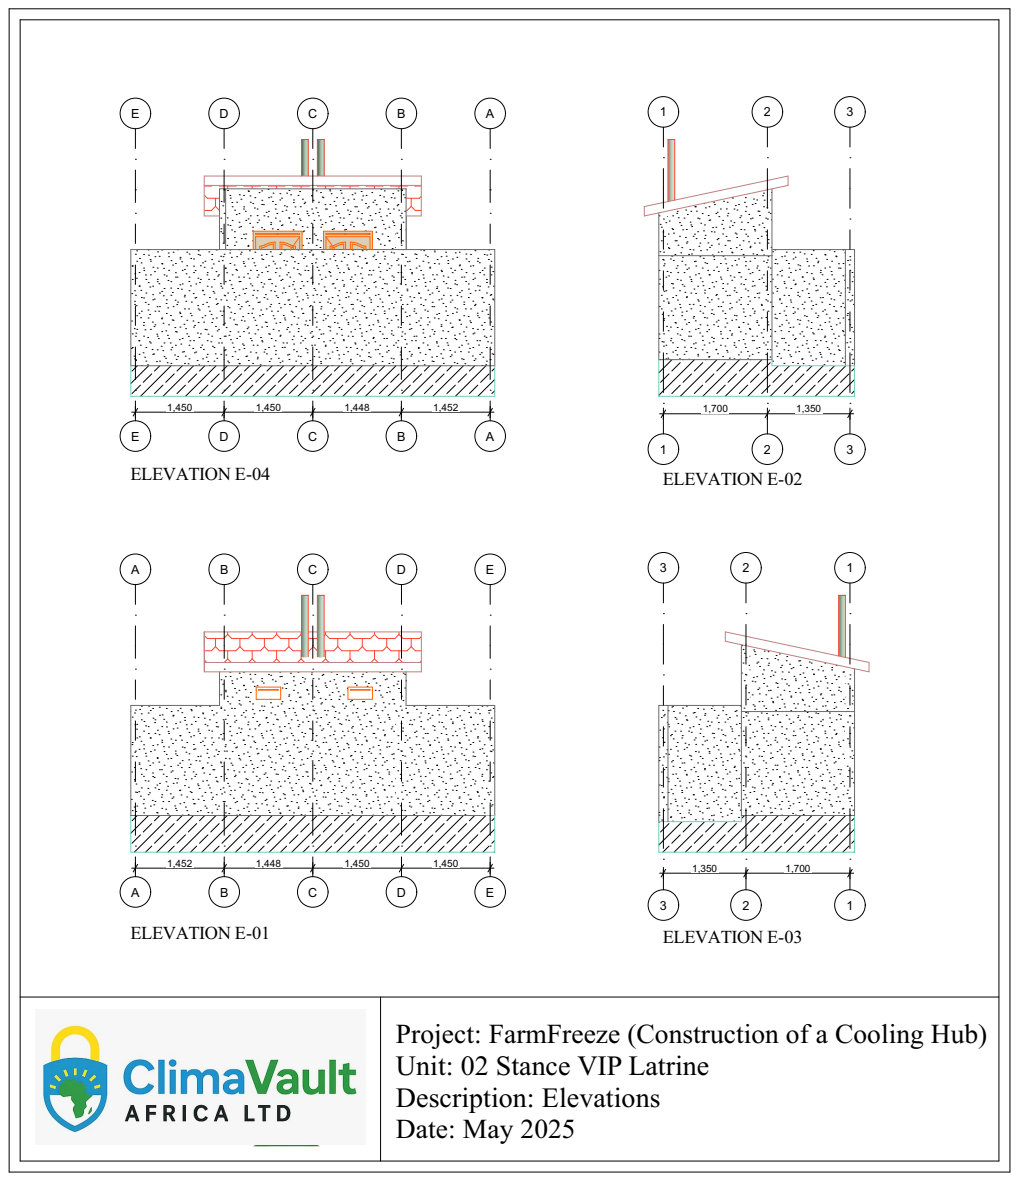
[picture p33: page 7]
ELEVATION E-04; ELEVATION E-02; ELEVATION E-01; ELEVATION E-03

Project: FarmFreeze (Construction of a Cooling Hub)
Unit: 02 Stance VIP Latrine
Description: Elevations
Date: May 2025

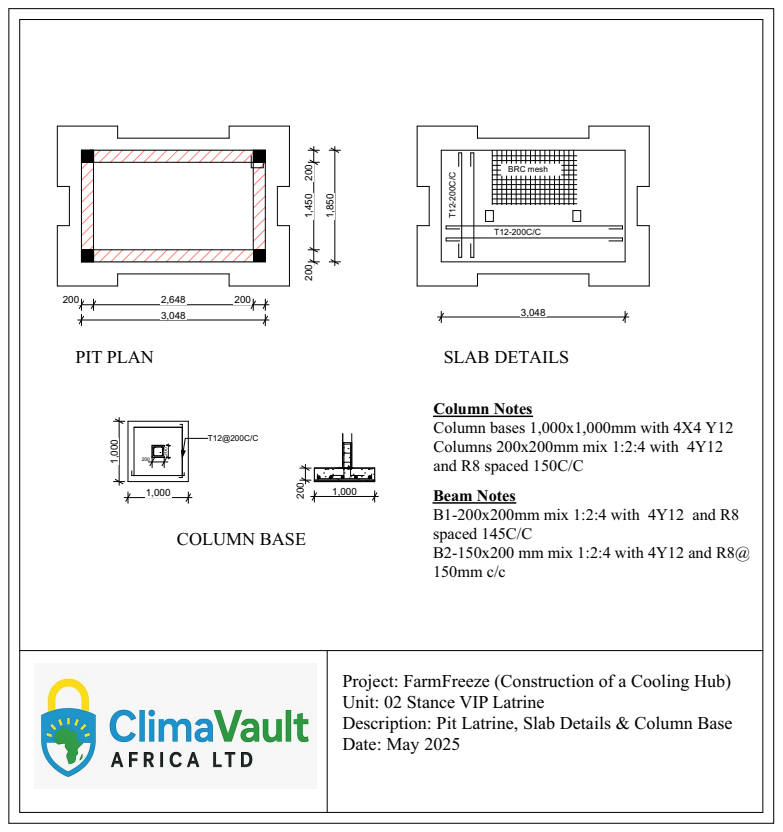
[picture p34: page 8]
BRC mesh; PIT PLAN; SLAB DETAILS; COLUMN BASE

Column Notes
Column bases 1,000x1,000mm with 4X4 Y12
Columns 200x200mm mix 1:2:4 with 4Y12
and R8 spaced 150C/C
Beam Notes
B1-200x200mm mix 1:2:4 with 4Y12 and R8
spaced 145C/C
B2-150x200 mm mix 1:2:4 with 4Y12 and R8@

Project: FarmFreeze (Construction of a Cooling Hub)
Unit: 02 Stance VIP Latrine
Description: Pit Latrine, Slab Details & Column Base
Date: May 2025

04

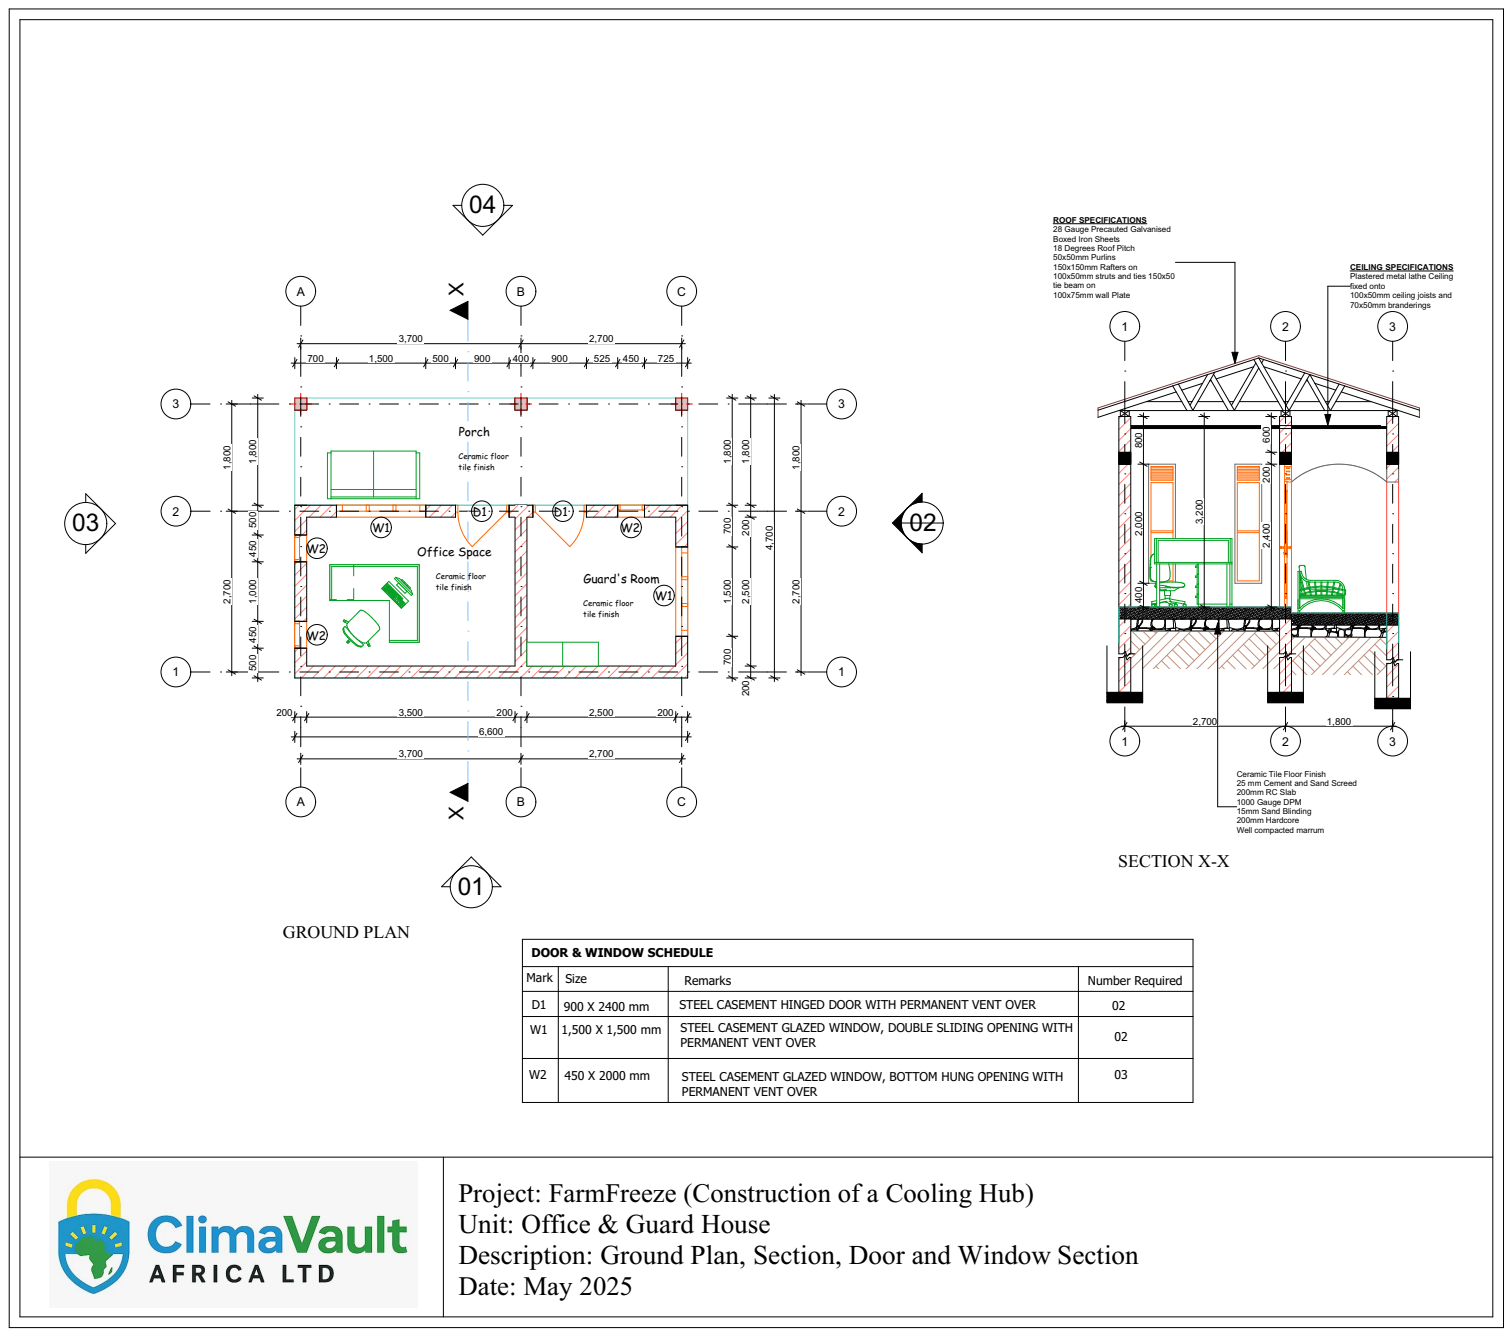
[picture p35: page 9]
Office Space; Ceramic floor tile finish; Guard's Room; Porch; GROUND PLAN; SECTION X-X

ROOF SPECIFICATIONS
28 Gauge Precauted Galvanised
Boxed Iron Sheets
18 Degrees Roof Pitch
50x50mm Purlins
150x150mm Rafters on
100x50mm struts and ties 150x50
tie beam on
100x75mm wall Plate

CEILING SPECIFICATIONS
Plastered metal lathe Ceiling
fixed onto
100x50mm ceiling joists and
70x50mm branderings

Ceramic Tile Floor Finish
25 mm Cement and Sand Screed
200mm RC Slab
1000 Gauge DPM
15mm Sand Blinding
200mm Hardcore
Well compacted marrum

DOOR & WINDOW SCHEDULE

Mark | Size | Remarks | Number Required
D1 | 900 X 2400 mm | STEEL CASEMENT HINGED DOOR WITH PERMANENT VENT OVER | 02
W1 | 1,500 X 1,500 mm | STEEL CASEMENT GLAZED WINDOW, DOUBLE SLIDING OPENING WITH PERMANENT VENT OVER | 02

W2 | 450 X 2000 mm | STEEL CASEMENT GLAZED WINDOW, BOTTOM HUNG OPENING WITH PERMANENT VENT OVER | 03

Project: FarmFreeze (Construction of a Cooling Hub)
Unit: Office & Guard House
Description: Ground Plan, Section, Door and Window Section
Date: May 2025

1

2

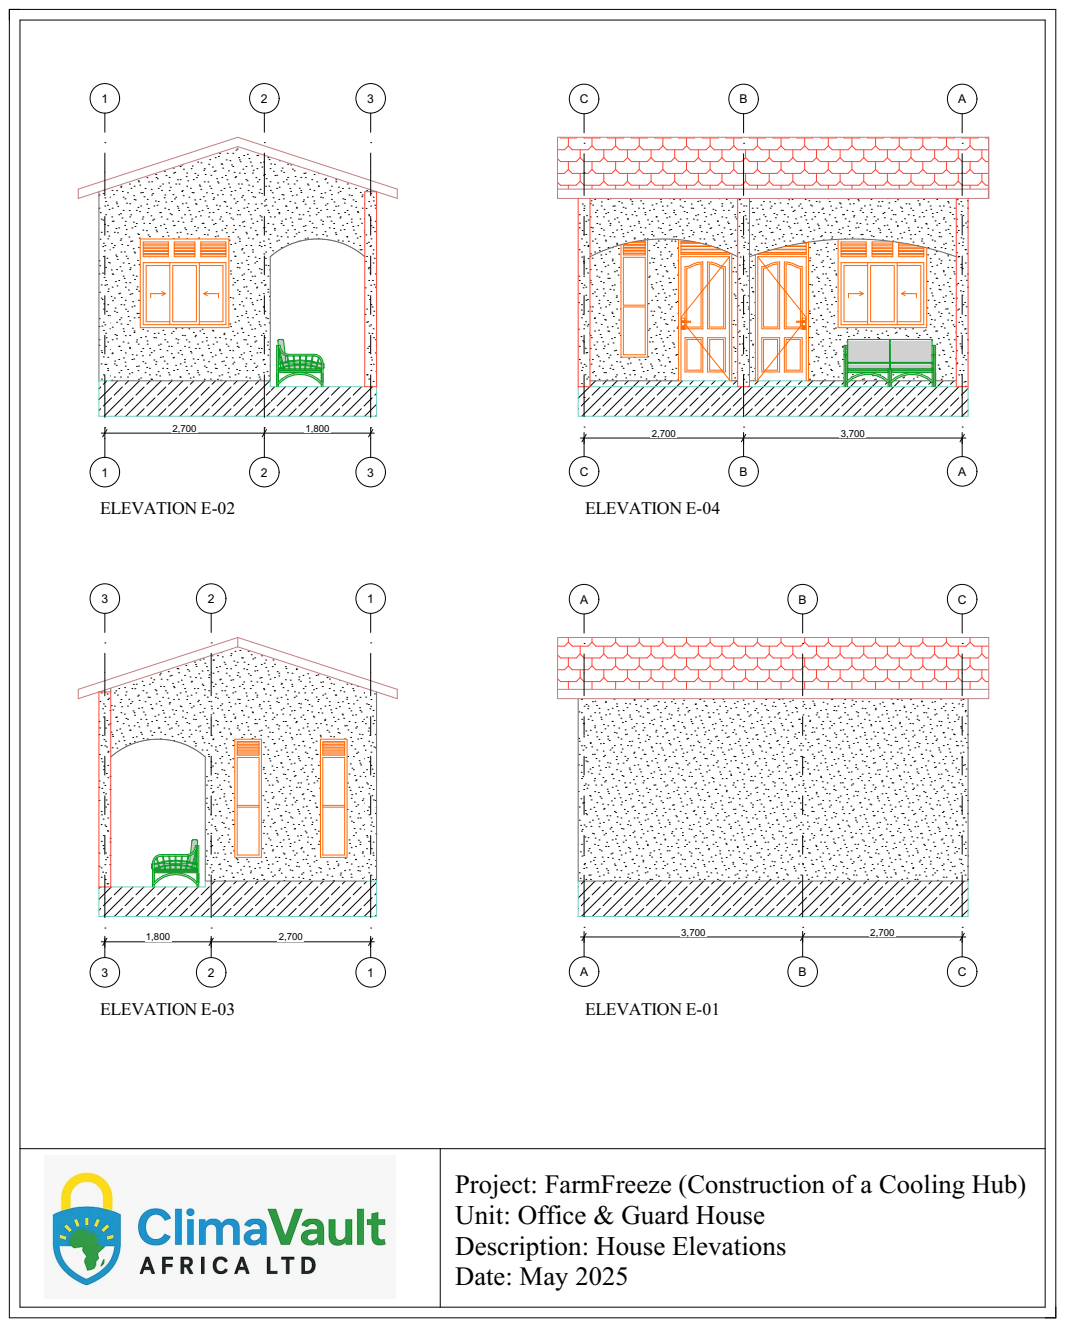
[picture p36: page 10]
ELEVATION E-02; ELEVATION E-04; ELEVATION E-03; ELEVATION E-01

Project: FarmFreeze (Construction of a Cooling Hub)
Unit: Office & Guard House
Description: House Elevations
Date: May 2025

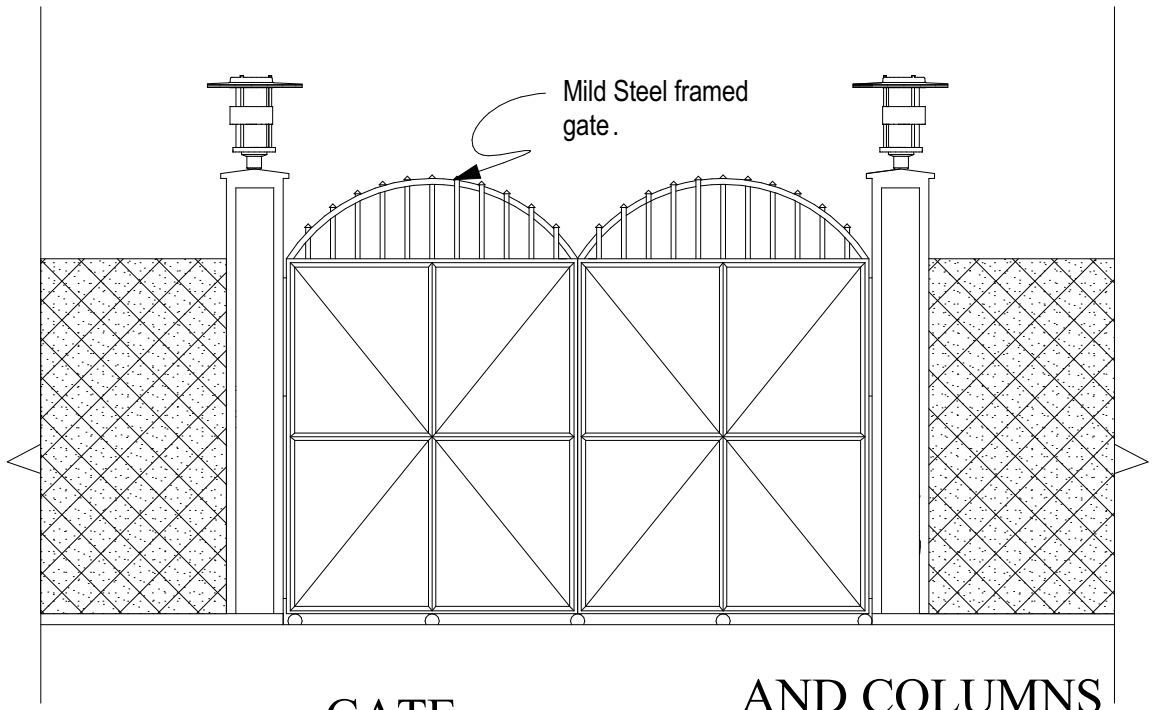
[picture p37: figure]
Mild Steel framed

# gate. 100 ⁴⁰⁰ 100 950 950 100 500 2100

100
450

100

500

100 400 100 950 950 100

500 2100

100
450

100

1000

45° | 45°

## 3.5x2.5m gate fabricated using 40x20mm steel hollow sections as major and minor members and 5mm thick gripped sheets double swing and a small emergency

access 700x1600mm with lockable provisions,

## complete with heavy duty hinges, padbolts and one coat of red oxide applied and anchored into 300x300mm concrete columns

## 2.1m high chainlink fence gauge 10 tensioned and securely fastened with binding wire to the rigidily set posts

## 400m long heavy duty berbed wire gauge 13 in 3 lines at the top of steel posts

## 5mm tension wire in 3 Lines to fasten the chain link

Details for steel post
100x100mm concrete posts with 45 degree bend at the top as shown with holes for passing the berbed wire, fixed to 450x450mm concrete base, class 20 to a depth not exceeding 600mm at 2.5m c/c with 200x400mm deep concrete class 15 to the base of chain link through out the entire perimeter.

Details for Bracing at the corner posts
100x100mm conrete post fastened to the vertical corner steel post on both sides at right angle, all fixed to 450x450mm concrete base, class 20 to a depth not exceeding 600mm.

## Gate and Fence Details

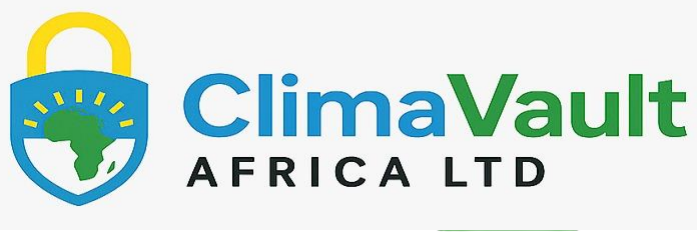
[picture p38: figure]

# Project: FarmFreeze (Construction of a Cooling Hub)

# Unit: Gate & Columns Description: Elevation and Details

# Date: May 2025

GATE | AND COLUMNS

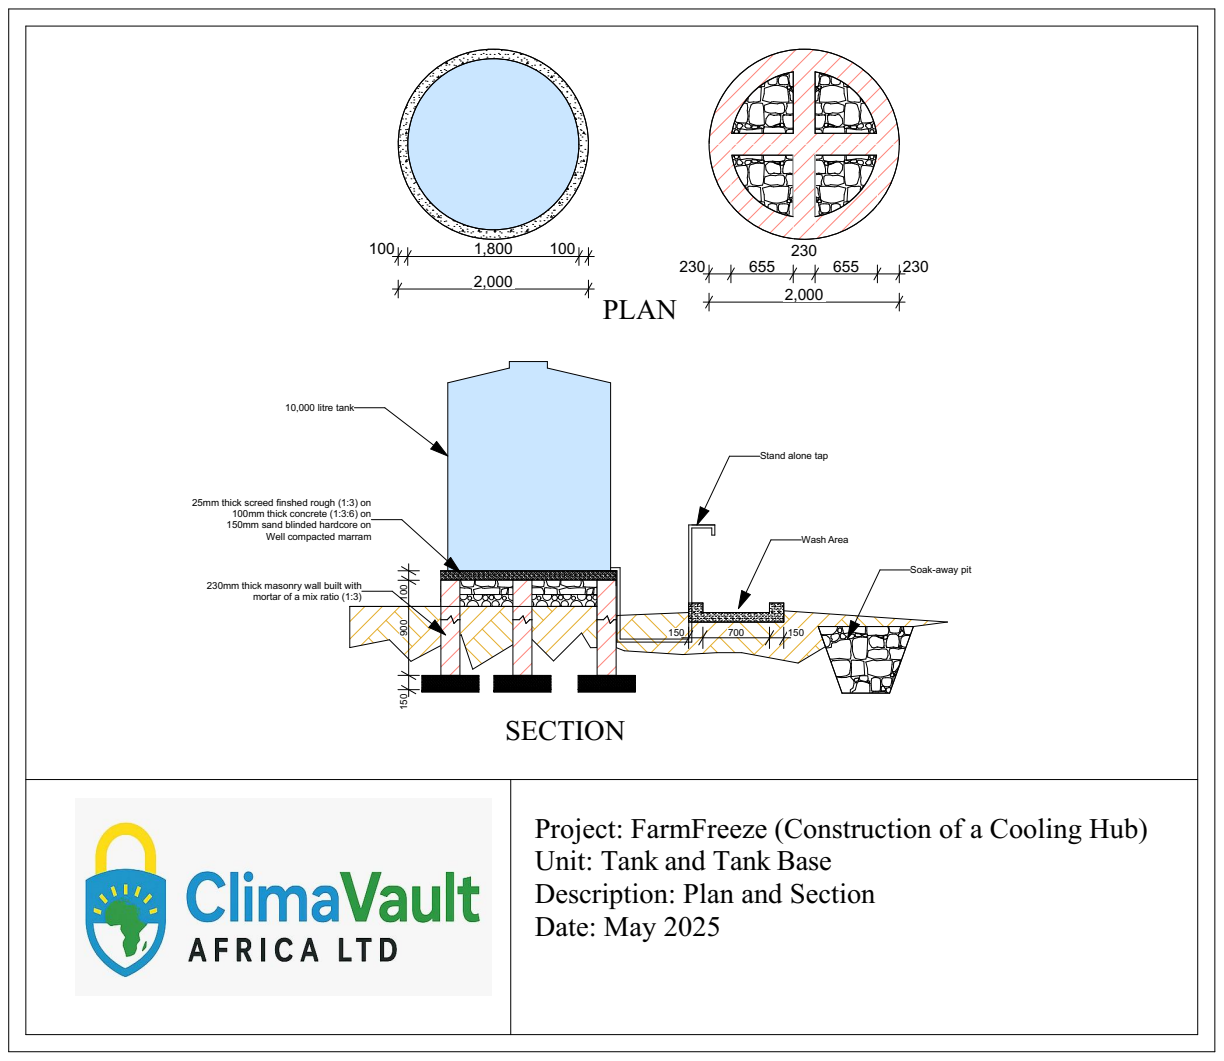
[picture p39: page 12]
10,000 litre tank; Wash Area; SECTION; PLAN

Stand alone tap

25mm thick screed finshed rough (1:3) on

100mm thick concrete (1:3:6) on
150mm sand blinded hardcore on

Well compacted marram

Soak-away pit

230mm thick masonry wall built with

mortar of a mix ratio (1:3)

Project: FarmFreeze (Construction of a Cooling Hub)
Unit: Tank and Tank Base
Description: Plan and Section
Date: May 2025
