IoT-App-Development-Company/AdequateSolarCold/cold-room-design/ColdRoom/CAD Exports/Cold Room.pdf

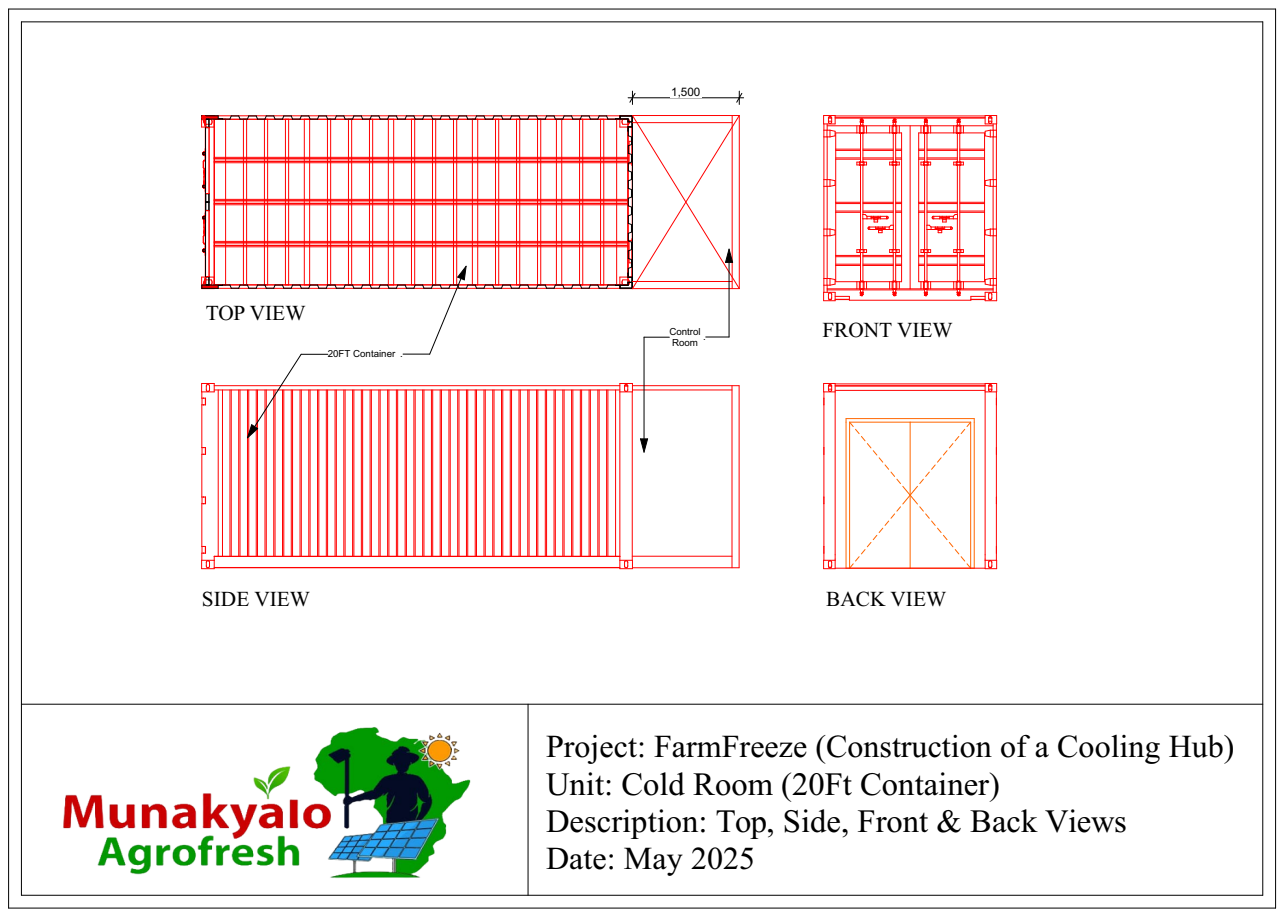
[picture p40: page 1]
GSPublisherVersion 0.1.100.100; 20FT Container .; Control Room .; TOP VIEW; FRONT VIEW; SIDE VIEW; BACK VIEW

Project: FarmFreeze (Construction of a Cooling Hub)
Unit: Cold Room (20Ft Container)
Description: Top, Side, Front & Back Views
Date: May 2025

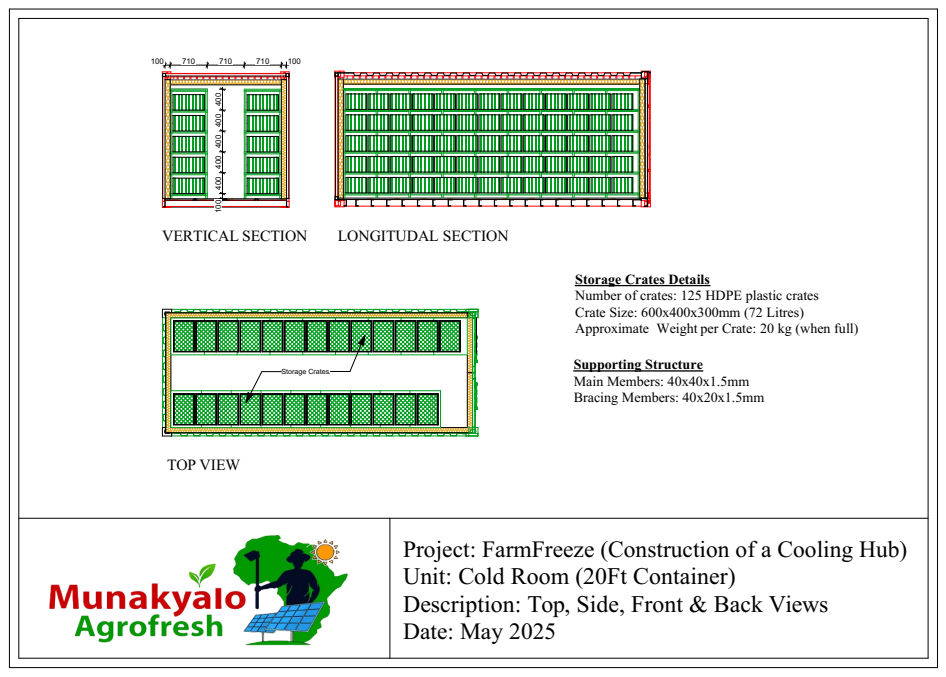
[picture p41: page 2]
TOP VIEW; VERTICAL SECTION; LONGITUDAL SECTION; Supporting Structure Main Members: 40x40x1.5mm Bracing Members: 40x20x1.5mm; Storage Crates.

Storage Crates Details
Number of crates: 125 HDPE plastic crates
Crate Size: 600x400x300mm (72 Litres)
Approximate Weight per Crate: 20 kg (when full)

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

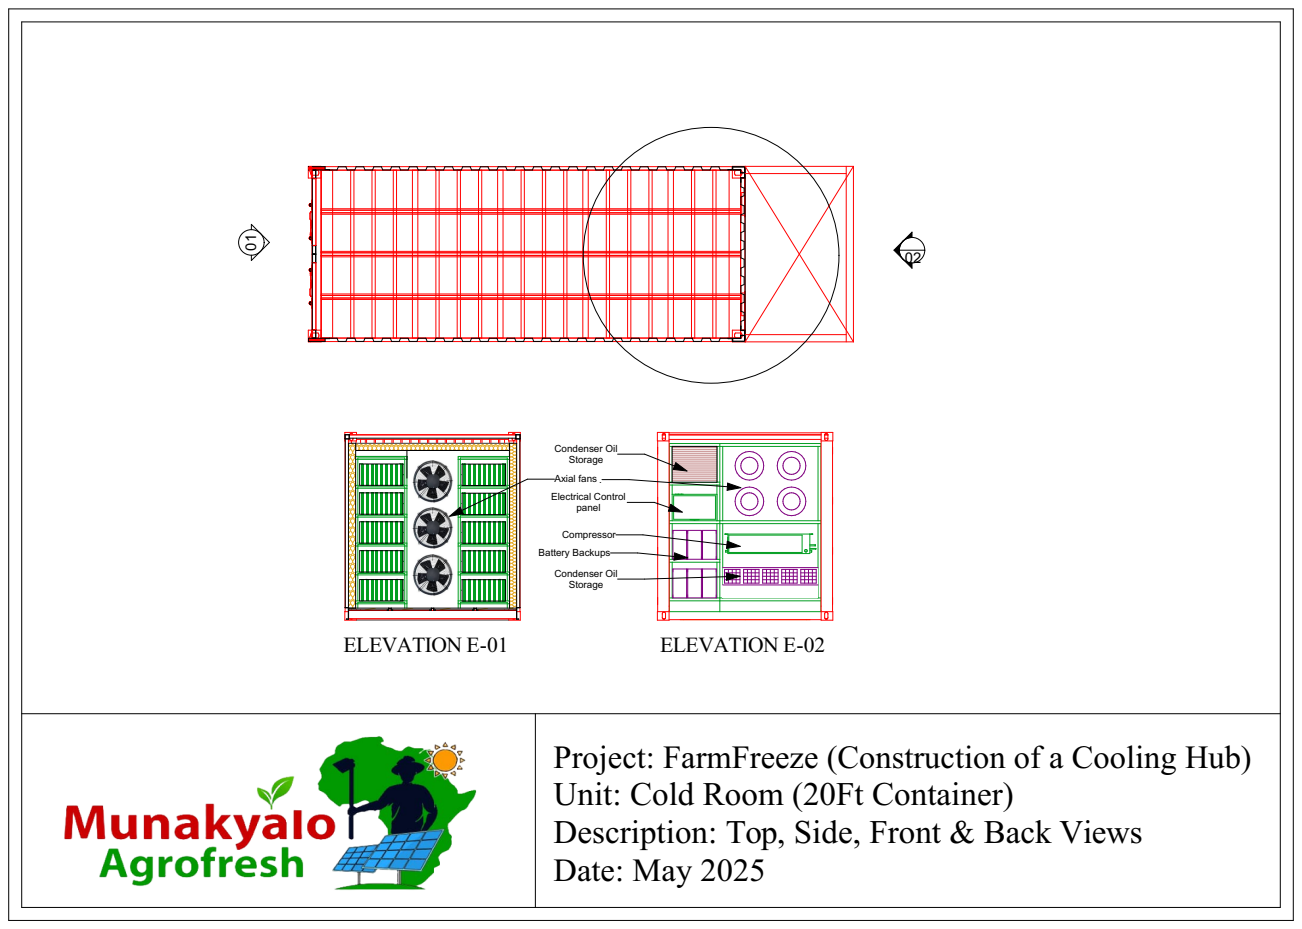
[picture p42: page 3]
GSPublisherVersion 0.0.100.100; ELEVATION E-01; ELEVATION E-02; Axial fans; Battery Backups; Electrical Control panel; Condenser Oil Storage; Compressor

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

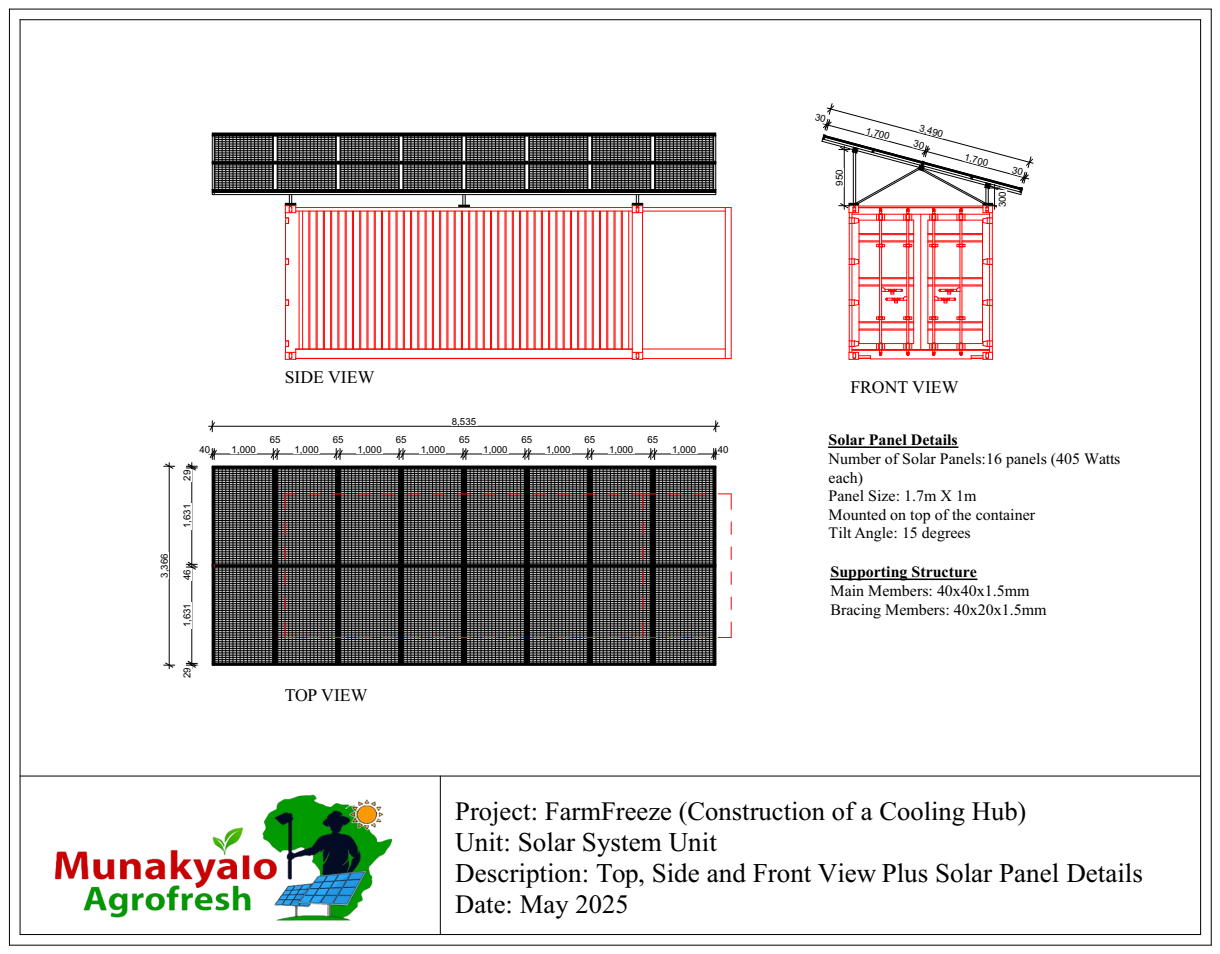
[picture p43: page 4]
SIDE VIEW; TOP VIEW; FRONT VIEW; Supporting Structure Main Members: 40x40x1.5mm Bracing Members: 40x20x1.5mm

Solar Panel Details
Number of Solar Panels:16 panels (405 Watts
each)
Panel Size: 1.7m X 1m
Mounted on top of the container
Tilt Angle: 15 degrees

Project: FarmFreeze (Construction of a Cooling Hub)
Unit: Solar System Unit
Description: Top, Side and Front View Plus Solar Panel Details
Date: May 2025
