IoT-App-Development-Company/AdequateSolarCold/cold-room-design/ColdRoom/CAD Exports/Office & Guard House.pdf

A

B | C

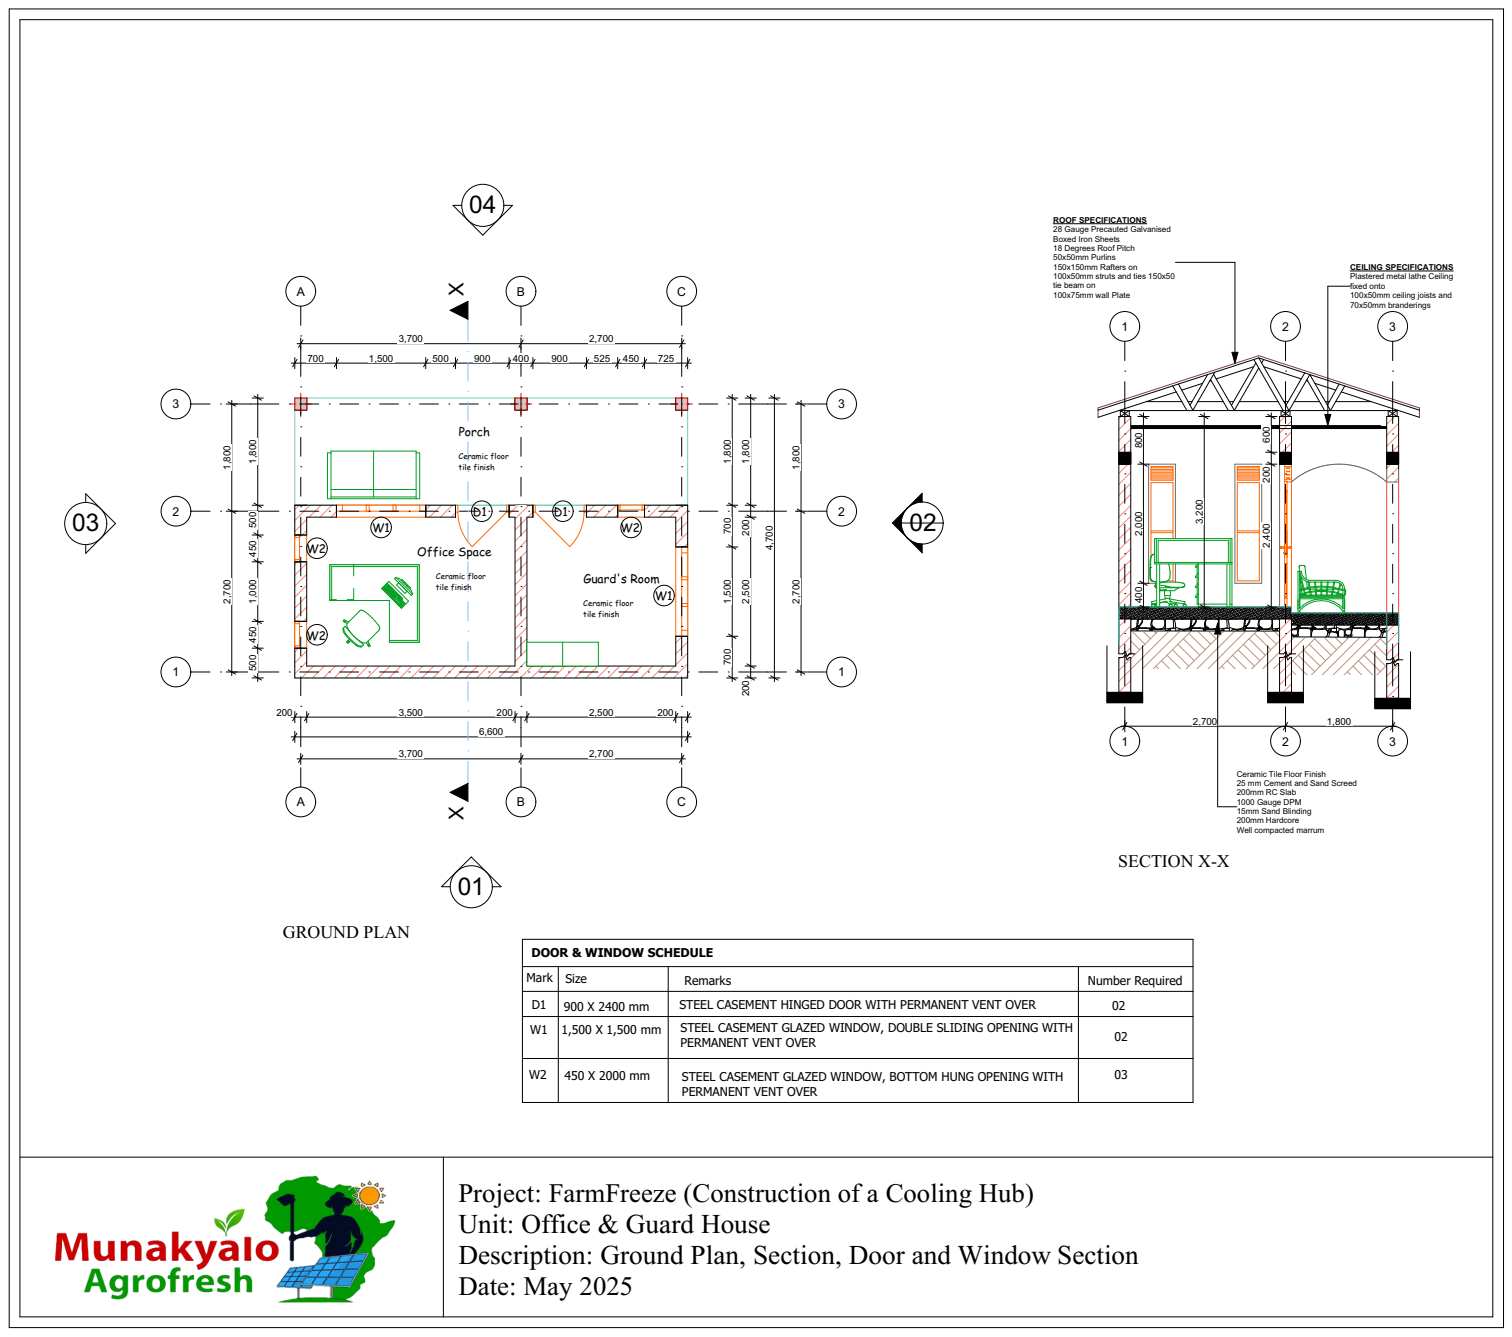
[picture p44: page 1]
GSPublisherVersion 0.0.100.100; Office Space; Ceramic floor tile finish; Guard's Room; Porch; GROUND PLAN; SECTION X-X

ROOF SPECIFICATIONS
28 Gauge Precauted Galvanised
Boxed Iron Sheets
18 Degrees Roof Pitch
50x50mm Purlins
150x150mm Rafters on
100x50mm struts and ties 150x50
tie beam on
100x75mm wall Plate

CEILING SPECIFICATIONS
Plastered metal lathe Ceiling
fixed onto
100x50mm ceiling joists and
70x50mm branderings

Ceramic Tile Floor Finish
25 mm Cement and Sand Screed
200mm RC Slab
1000 Gauge DPM
15mm Sand Blinding
200mm Hardcore
Well compacted marrum

DOOR & WINDOW SCHEDULE

Mark | Size | Remarks | Number Required
D1 | 900 X 2400 mm | STEEL CASEMENT HINGED DOOR WITH PERMANENT VENT OVER | 02
W1 | 1,500 X 1,500 mm | STEEL CASEMENT GLAZED WINDOW, DOUBLE SLIDING OPENING WITH PERMANENT VENT OVER | 02

W2 | 450 X 2000 mm | STEEL CASEMENT GLAZED WINDOW, BOTTOM HUNG OPENING WITH PERMANENT VENT OVER | 03

Project: FarmFreeze (Construction of a Cooling Hub)
Unit: Office & Guard House
Description: Ground Plan, Section, Door and Window Section
Date: May 2025

1

2

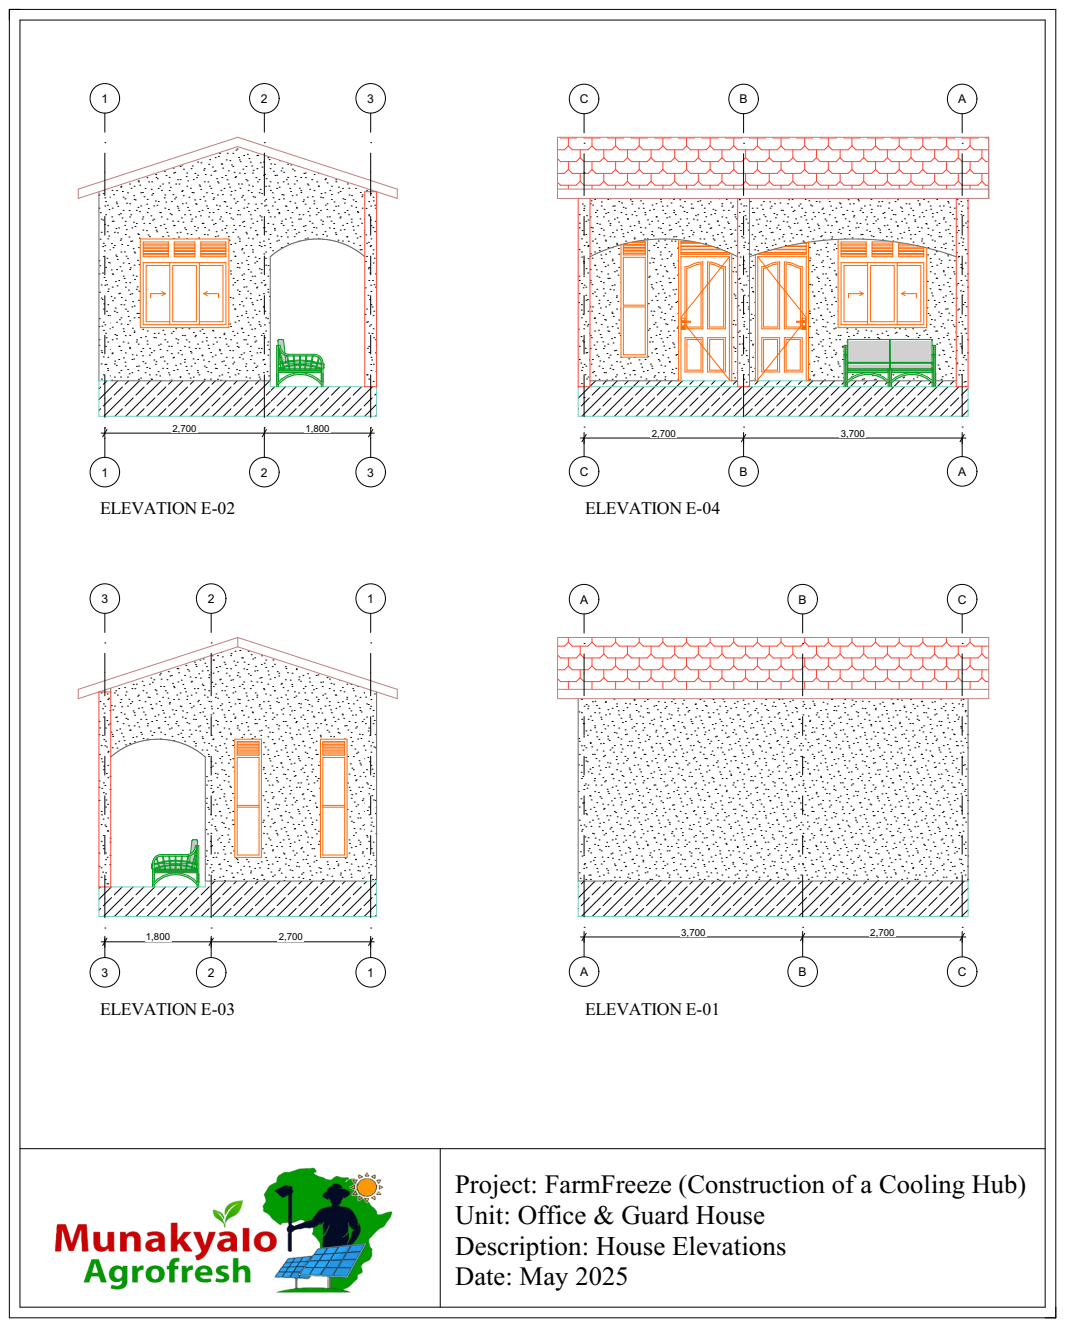
[picture p45: page 2]
GSPublisherVersion 0.0.100.100; ELEVATION E-02; ELEVATION E-04; ELEVATION E-03; ELEVATION E-01

Project: FarmFreeze (Construction of a Cooling Hub)
Unit: Office & Guard House
Description: House Elevations
Date: May 2025
