IoT-App-Development-Company/AdequateSolarCold/(list of files, drawings)

Other design files:
simulation/Cold Solar Storage Proteus Simulation.pdsprj
