IoT-App-Development-Company/AdequateSolarCold/pcb-design/Solar Cooling Project.kicad_pcb

## KiCad design pcb-design/Solar Cooling Project.kicad_pcb (2026-10-26)

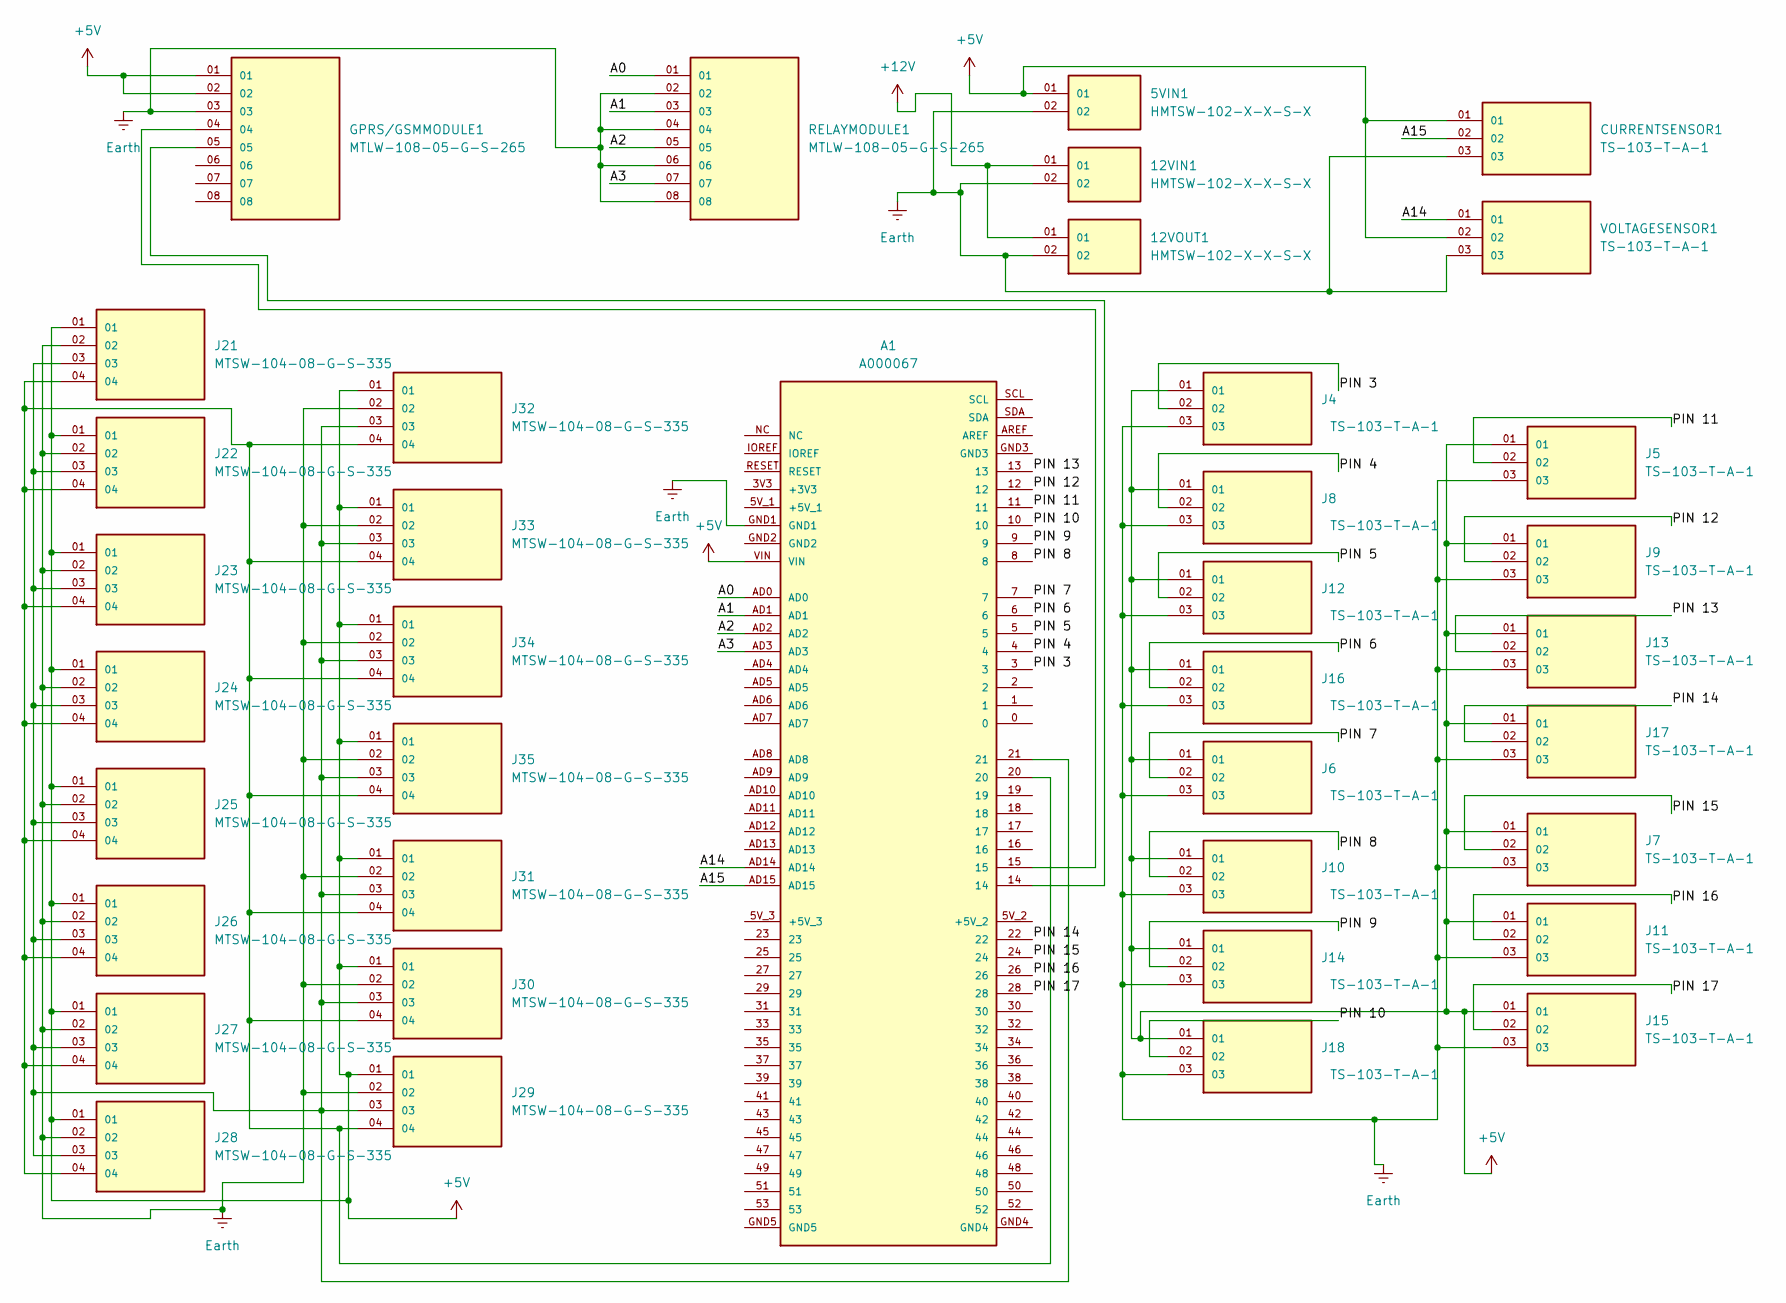
[picture p46: schematic Solar Cooling Project.kicad_sch]

Parts:
5VIN1, 12VIN1, 12VOUT1: HMTSW-102-X-X-S-X; SAMTEC_HMTSW-102-X-X-S-X; PARTREV A
A1: A000067; MODULE_A000067; PARTREV 3
CURRENTSENSOR1: TS-103-T-A-1; SAMTEC_TS-103-T-A-1; PARTREV R
GPRS/GSMMODULE1: MTLW-108-05-G-S-265; SAMTEC_MTLW-108-05-G-S-265; PARTREV R
J4, J5, J6, J7, J8, J9, J10, J11, J12, J13, J14, J15, J16, J17, J18: TS-103-T-A-1; SAMTEC_TS-103-T-A-1; PARTREV R
J21, J22, J23, J24, J25, J26, J27, J28, J29, J30, J31, J32, J33, J34, J35: MTSW-104-08-G-S-335; SAMTEC_MTSW-104-08-G-S-335; PARTREV R
RELAYMODULE1: MTLW-108-05-G-S-265; SAMTEC_MTLW-108-05-G-S-265; PARTREV R
VOLTAGESENSOR1: TS-103-T-A-1; SAMTEC_TS-103-T-A-1; PARTREV R

Connections:
+5V: 5VIN1.01, A1.VIN, CURRENTSENSOR1.01, GPRS/GSMMODULE1.01, GPRS/GSMMODULE1.02, J4.01, J5.01, J6.01, J7.01, J8.01, J9.01, J10.01, J11.01, J12.01, J13.01, J14.01, J15.01, J16.01, J17.01, J18.01, J21.01, J22.01, J23.01, J24.01, J25.01, J26.01, J27.01, J28.01, J29.01, J30.01, J31.01, J32.01, J33.01, J34.01, J35.01, VOLTAGESENSOR1.02
+12V: 12VIN1.01, 12VOUT1.01
/A0: A1.AD0, RELAYMODULE1.01
/A1: A1.AD1, RELAYMODULE1.03
/A2: A1.AD2, RELAYMODULE1.05
/A3: A1.AD3, RELAYMODULE1.07
/A14: A1.AD14, VOLTAGESENSOR1.01
/A15: A1.AD15, CURRENTSENSOR1.02
/PIN 3: A1.3, J4.02
/PIN 4: A1.4, J8.02
/PIN 5: A1.5, J12.02
/PIN 6: A1.6, J16.02
/PIN 7: A1.7, J6.02
/PIN 8: A1.8, J10.02
/PIN 9: A1.9, J14.02
/PIN 10: A1.10, J18.02
/PIN 11: A1.11, J5.02
/PIN 12: A1.12, J9.02
/PIN 13: A1.13, J13.02
/PIN 14: A1.22, J17.02
/PIN 15: A1.24, J7.02
/PIN 16: A1.26, J11.02
/PIN 17: A1.28, J15.02
Earth: 5VIN1.02, 12VIN1.02, 12VOUT1.02, A1.GND1, CURRENTSENSOR1.03, GPRS/GSMMODULE1.03, J4.03, J5.03, J6.03, J7.03, J8.03, J9.03, J10.03, J11.03, J12.03, J13.03, J14.03, J15.03, J16.03, J17.03, J18.03, J21.02, J22.02, J23.02, J24.02, J25.02, J26.02, J27.02, J28.02, J29.02, J30.02, J31.02, J32.02, J33.02, J34.02, J35.02, RELAYMODULE1.02, RELAYMODULE1.04, RELAYMODULE1.06, RELAYMODULE1.08, VOLTAGESENSOR1.03
unnamed: A1.14, GPRS/GSMMODULE1.05
unnamed: A1.15, GPRS/GSMMODULE1.04
unnamed: A1.20, J21.04, J22.04, J23.04, J24.04, J25.04, J26.04, J27.04, J28.04, J29.04, J30.04, J31.04, J32.04, J33.04, J34.04, J35.04
unnamed: A1.21, J21.03, J22.03, J23.03, J24.03, J25.03, J26.03, J27.03, J28.03, J29.03, J30.03, J31.03, J32.03, J33.03, J34.03, J35.03

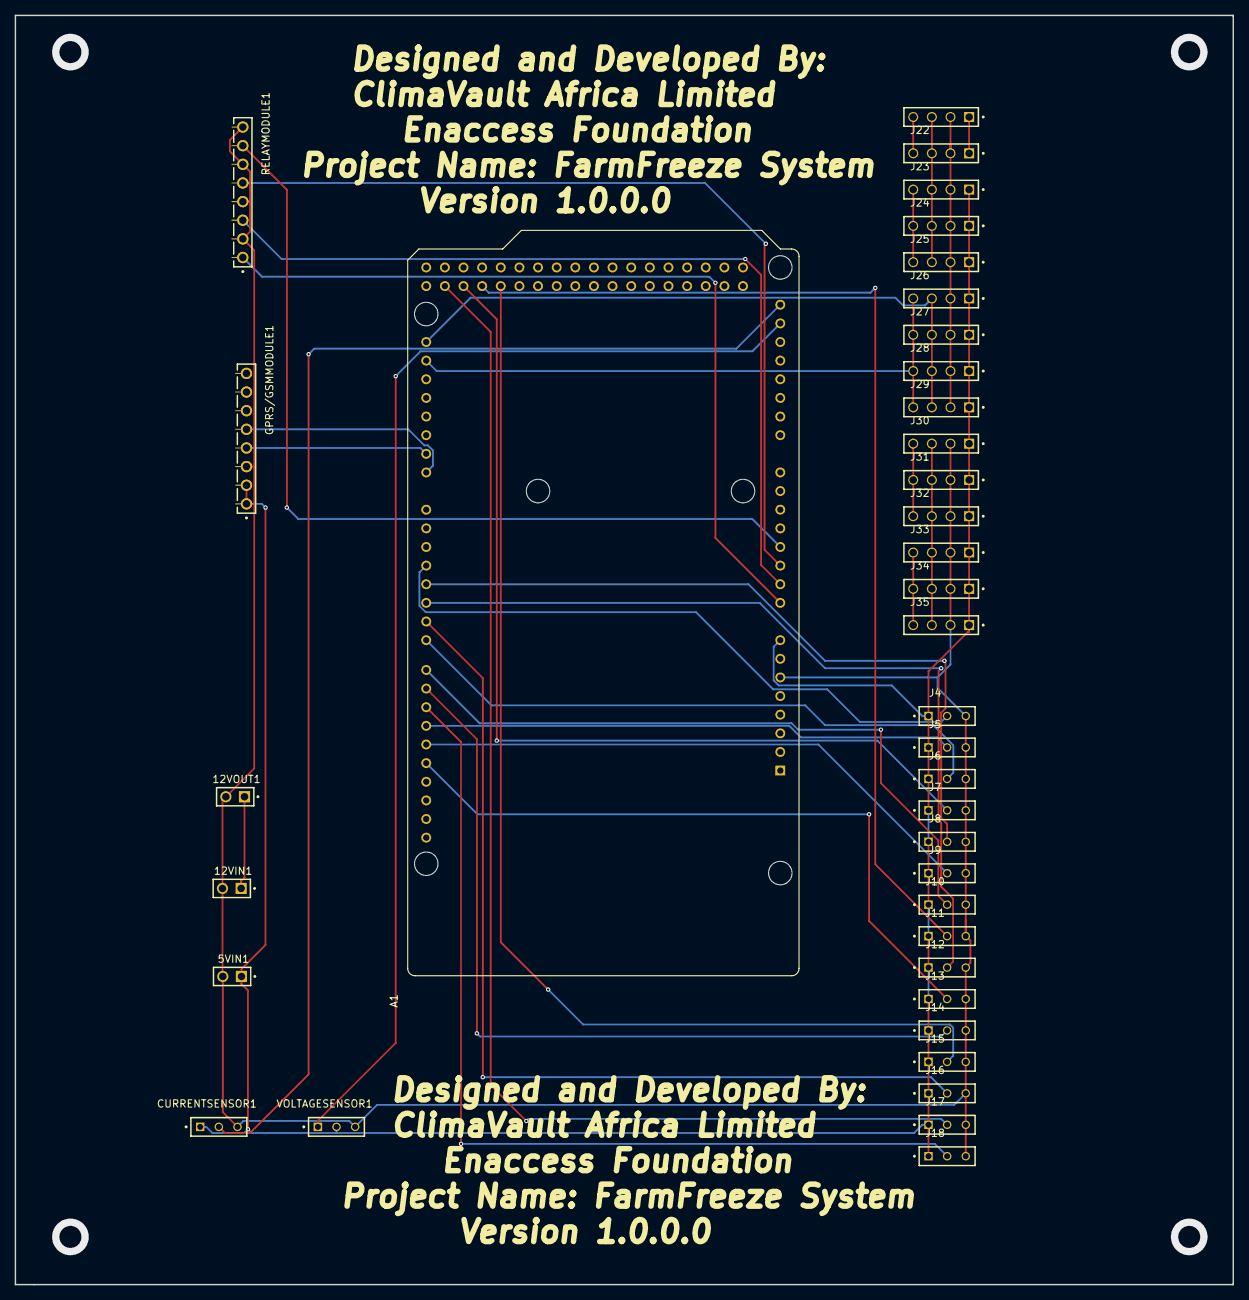
[picture p47: board Solar Cooling Project.kicad_pcb from above]

Board: 2 copper layers, 166.0 x 173.0 mm, 38 parts (0 on the bottom side), 28 nets.
